haberkern-lab/ethoVR/README.md

# ethoVR Documentation
Documentation for a Unity-based virtual reality system for neurobiology and ethology applications.
