haberkern-lab/ethoVR/index.md

---
layout: default
title: Home
nav_order: 1
permalink: /
---

## ethoVR
{: .fs-9 }

Documentation for a Unity-based virtual reality system for neurobiology and ethology applications.
{: .fs-6 .fw-300 }

This documentation is meant as a practical guide for scientists to set up their own Unity-based virtual reality system using modules from the Janelia Unity Toolkit. In addition to "How-to guides" for the modular software, this website provides information to hardware, design files for custom 3D printed parts and assembly instructions.

If you use tools described on this website, please reference the following manuscript:
> [Maintaining a stable head direction representation in naturalistic visual environments](https://biorxiv.org/content/10.1101/2022.05.17.492284v1.full).
> Hannah Haberkern, Shivam S Chitnis, Philip M Hubbard, Tobias Goulet, Ann M Hermundstad, Vivek Jayaraman
> bioRxiv 2022.05.17.492284; doi: https://doi.org/10.1101/2022.05.17.492284

For the Janelia Unity Toolkit, please cite the following DOI:
> Philip Hubbard. (2022). 
> JaneliaSciComp/janelia-unity-toolkit: v1.1.0 (v1.1.0). 
> Zenodo. https://doi.org/10.5281/zenodo.7032144

The Janelia Unity Toolkit provides software packages that extend Unity functionality in a modular manner to accommodate specialized needs for applications of virtual reality to neuroscience and (neuro-)ethology. These packages allow precise control of frame rate, setup of a panoramic display, a connection with FicTrac via socket connection, custom collision handling, data logging and more. In addition, here we provide information on building hardware for a virtual reality system that permits neural recordings in behaving insects.

[Get started now](https://haberkern-lab.github.io/ethoVR/getting-started/){: .btn .btn-primary .fs-5 .mb-4 .mb-md-0 .mr-2 }  [Janelia Unity Toolkit](https://github.com/JaneliaSciComp/janelia-unity-toolkit){: .btn .fs-5 .mb-4 .mb-md-0 }

---

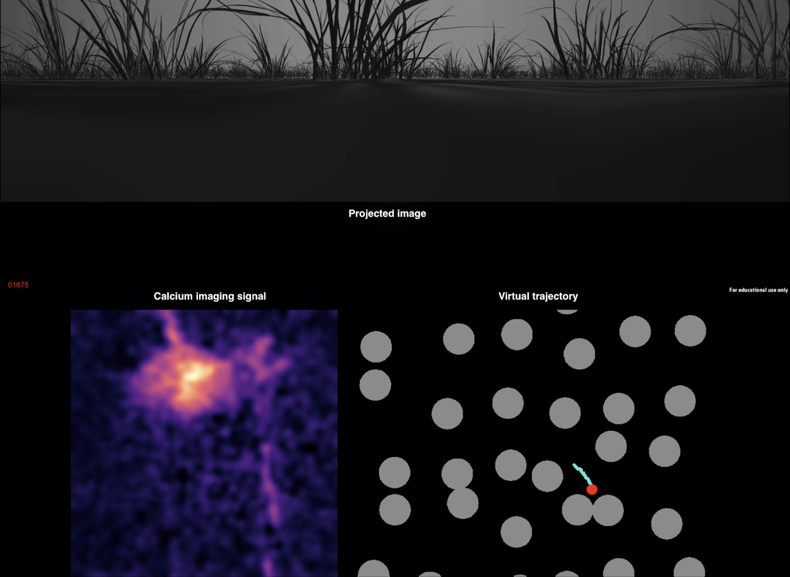
[picture p6: assets/DemoImage.png]
intro image

##### An example application where a fly explored an immersive visual virtual reality during simultaneous two-photon calcium imaging.
