haberkern-lab/ethoVR/assets/coolingForProjectors/image001.png

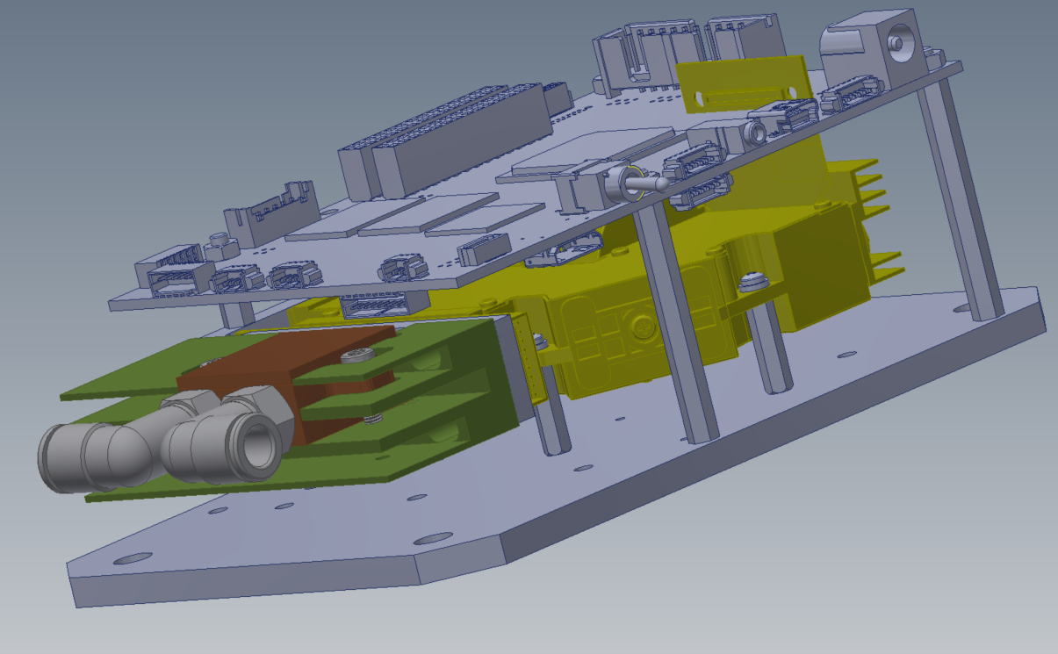
assets/coolingForProjectors/image001.png
