haberkern-lab/ethoVR/assets/coolingForProjectors/image002.png

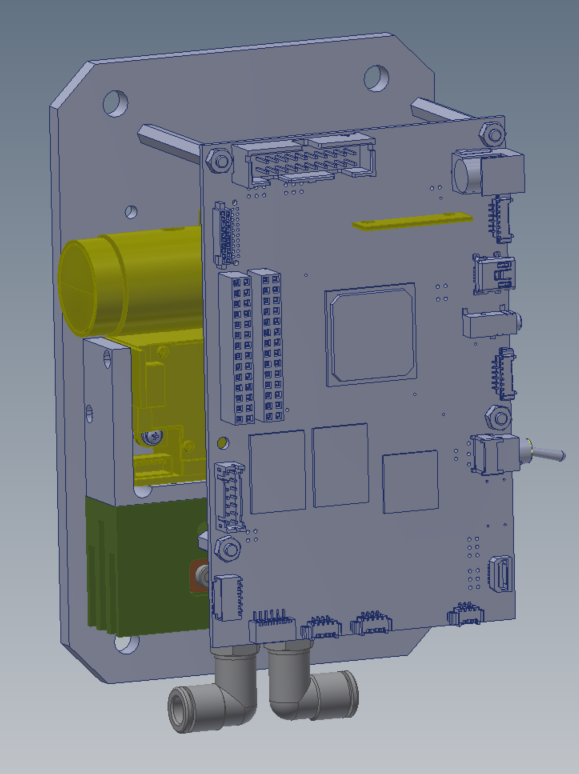
assets/coolingForProjectors/image002.png
