haberkern-lab/ethoVR/assets/coolingForProjectors/image003.png

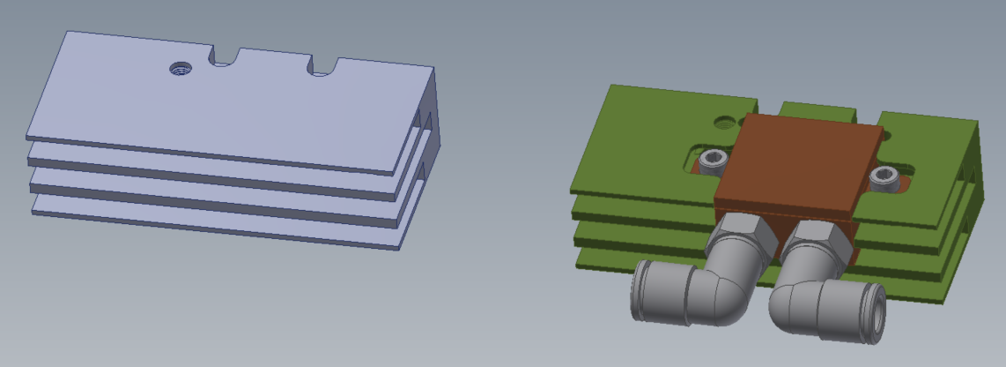
assets/coolingForProjectors/image003.png
