haberkern-lab/ethoVR/assets/coolingForProjectors/image004.png

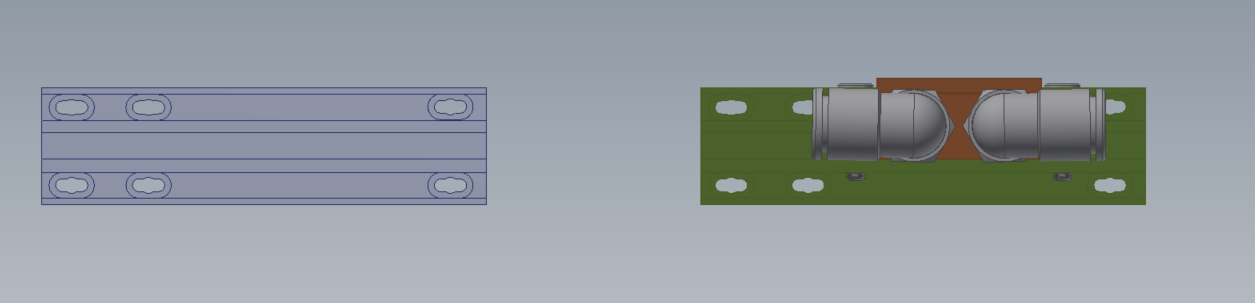
assets/coolingForProjectors/image004.png
