haberkern-lab/ethoVR/assets/display/3projectorScreen_rendering.png

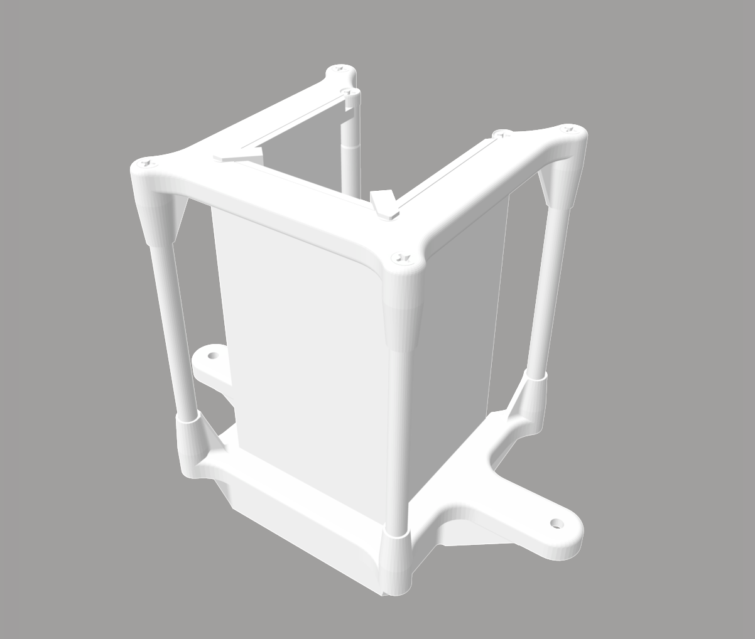
assets/display/3projectorScreen_rendering.png
