haberkern-lab/ethoVR/assets/display/4projectorScreen/displayLayout_front.png

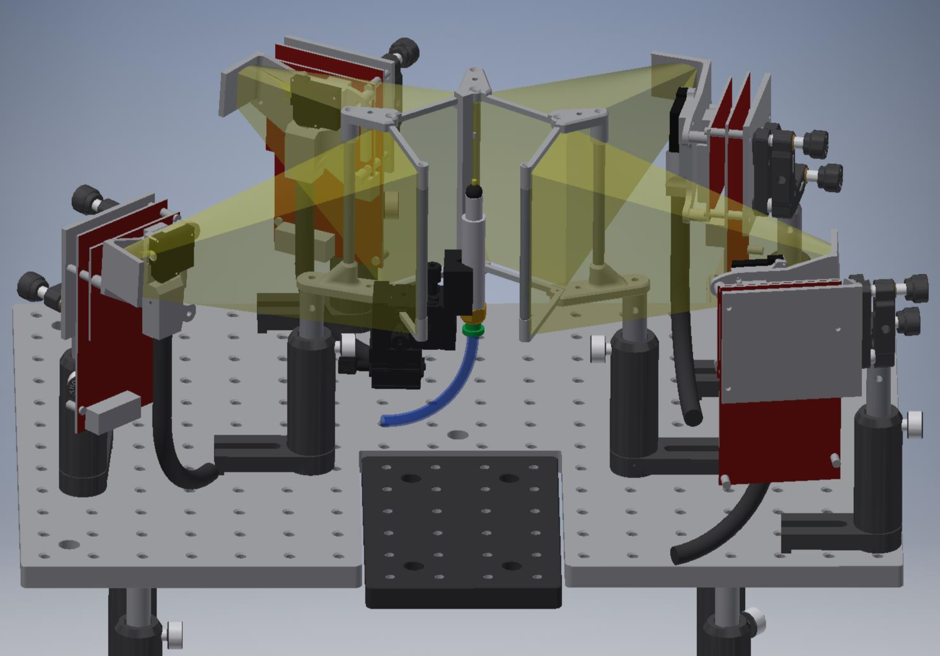
assets/display/4projectorScreen/displayLayout_front.png
