haberkern-lab/ethoVR/assets/display/4projectorScreen/displayLayout_side.png

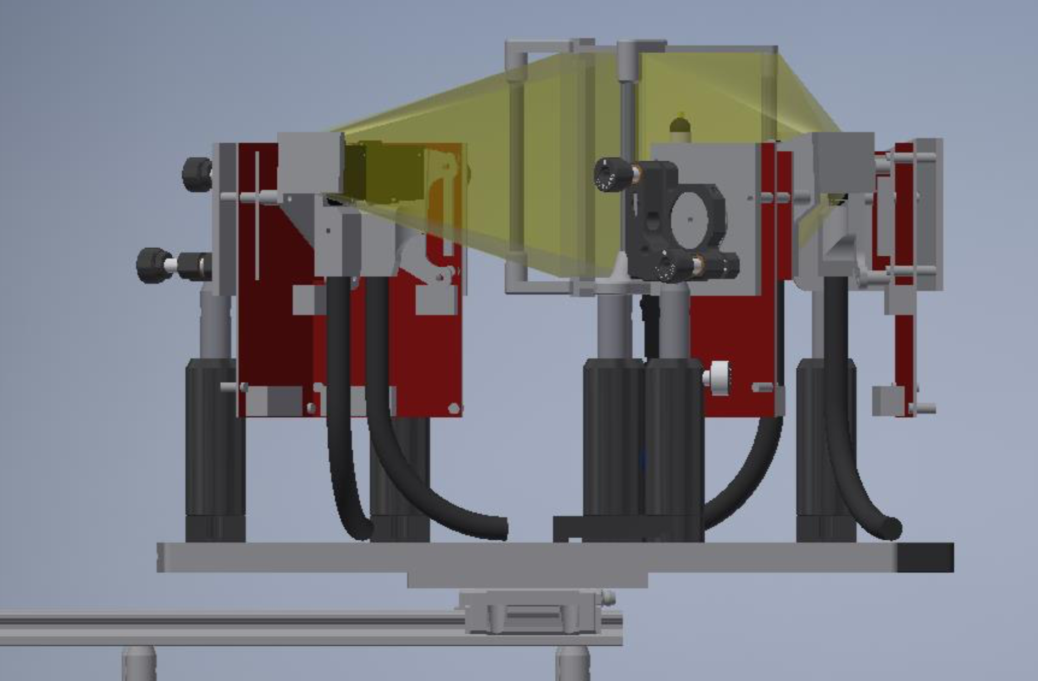
assets/display/4projectorScreen/displayLayout_side.png
