haberkern-lab/ethoVR/assets/display/4projectorScreen/displayLayout_top.png

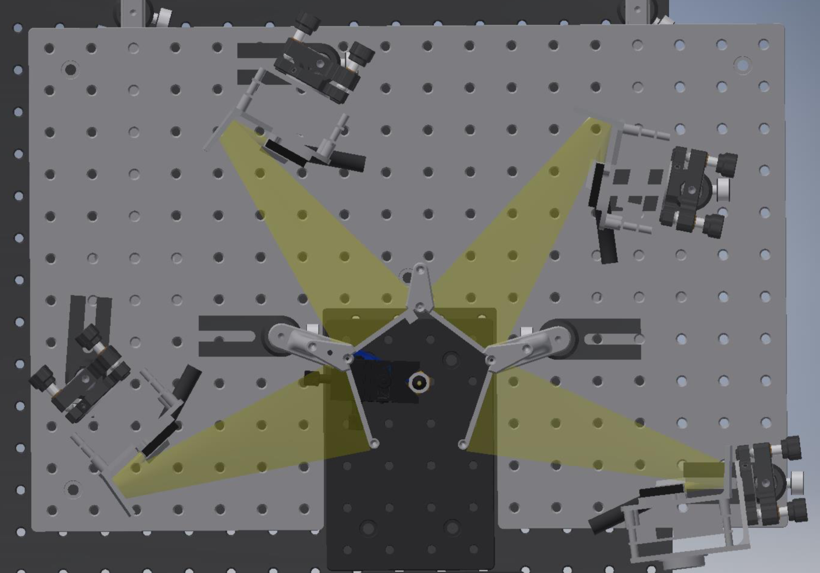
assets/display/4projectorScreen/displayLayout_top.png
