haberkern-lab/ethoVR/assets/display/imagingRig_projectors_photo.jpg

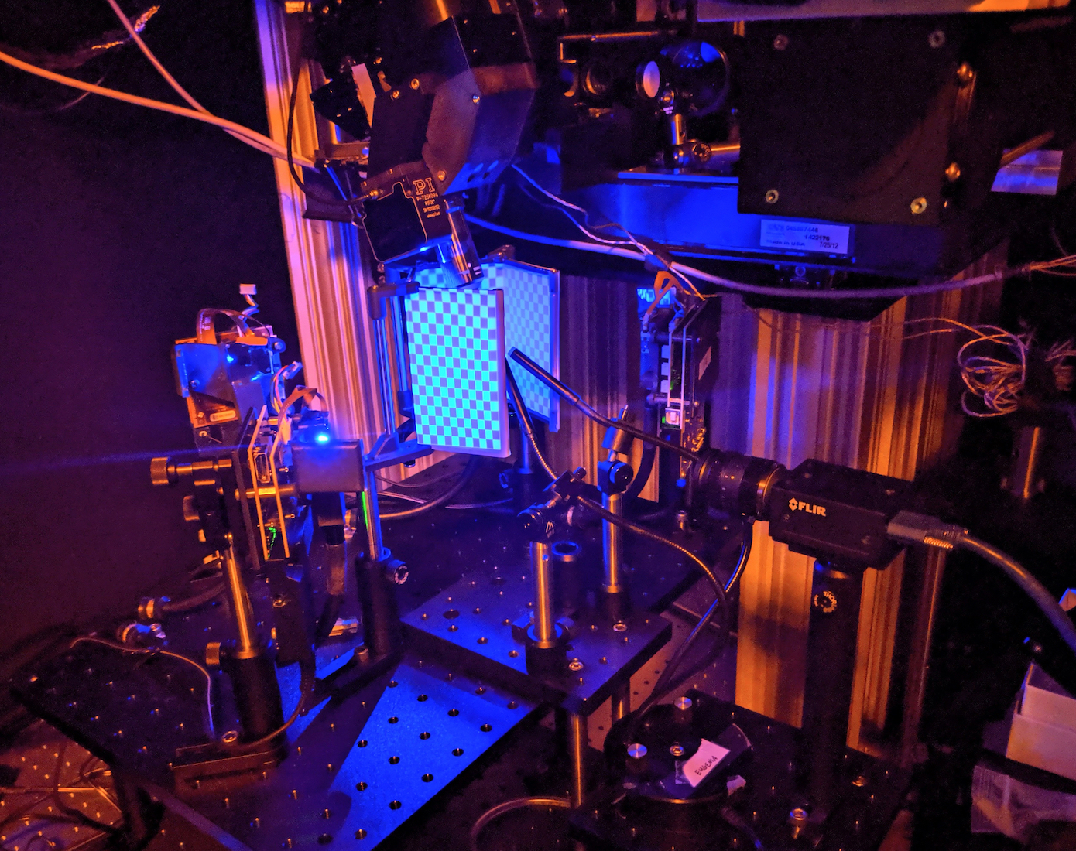
assets/display/imagingRig_projectors_photo.jpg
