haberkern-lab/ethoVR/assets/display/screen_styles.jpg

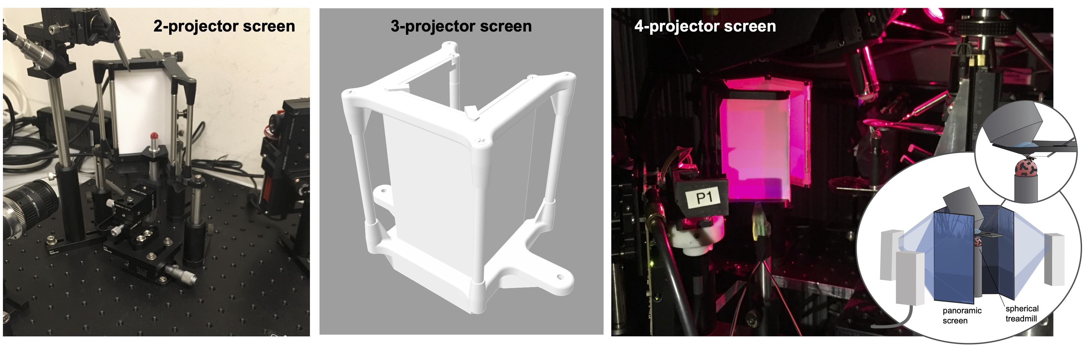
assets/display/screen_styles.jpg
