haberkern-lab/ethoVR/assets/fictrac/fictrac-configImg.png

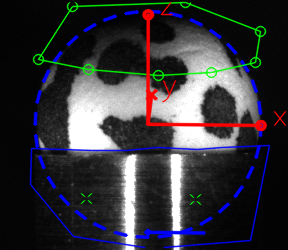
assets/fictrac/fictrac-configImg.png
