haberkern-lab/ethoVR/assets/flyholder/flyholder_connector.png

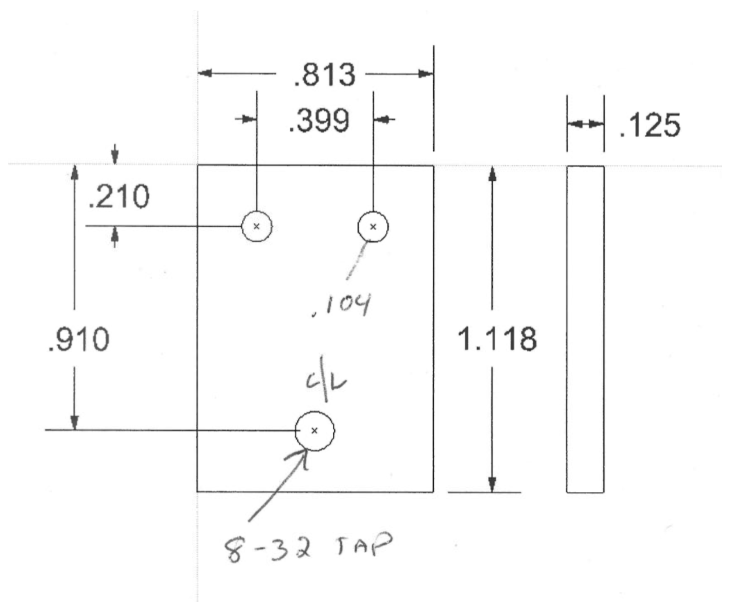
assets/flyholder/flyholder_connector.png
