haberkern-lab/ethoVR/assets/flyholder/frame2.png

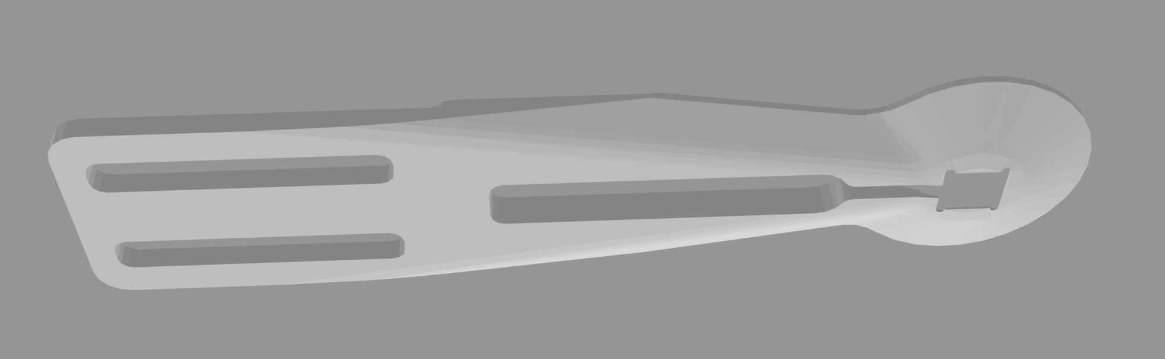
assets/flyholder/frame2.png
