haberkern-lab/ethoVR/assets/flyholder/frame.png

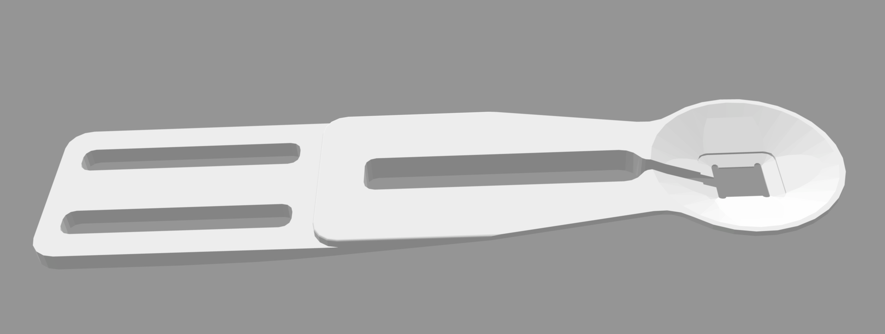
assets/flyholder/frame.png
