haberkern-lab/ethoVR/assets/screenDimensions.png

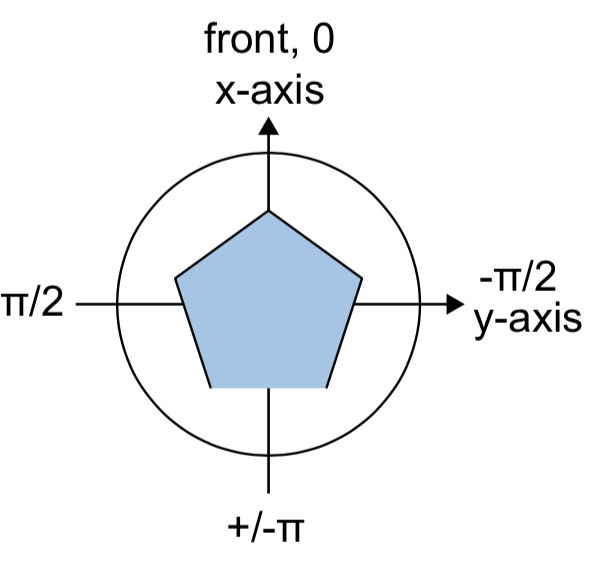
assets/screenDimensions.png
