haberkern-lab/ethoVR/assets/display/2projectorScreen/SCREEN ASSEMBLY GUIDE.stl

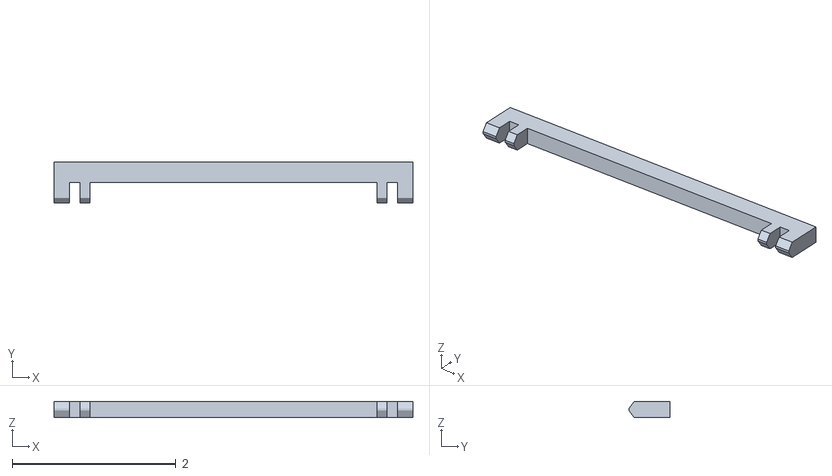
[picture p22: CAD file, 2022-11-30]
assets/display/2projectorScreen/SCREEN ASSEMBLY GUIDE.stl
4.39 x 0.5 x 0.2
