haberkern-lab/ethoVR/assets/modelfiles/fullAssembly 3P.stl

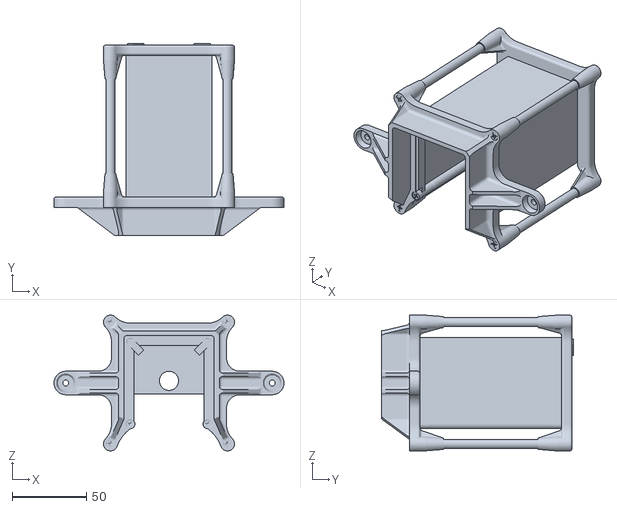
[picture p23: CAD file, 2026-02-27]
assets/modelfiles/fullAssembly 3P.stl
154.8 x 129.3 x 91.4
