haberkern-lab/ethoVR/assets/modelfiles/SCREEN ASSEMBLY GUIDE 3P.stl

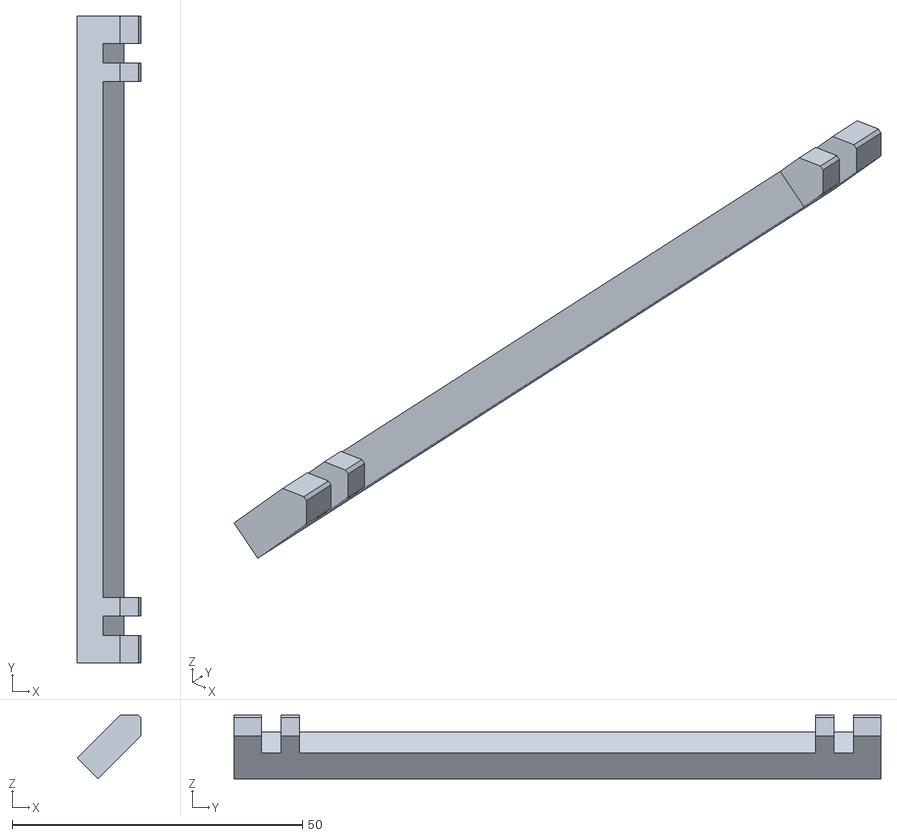
[picture p24: CAD file, 2024-01-26]
assets/modelfiles/SCREEN ASSEMBLY GUIDE 3P.stl
11.0 x 111.4 x 11.0
