haberkern-lab/ethoVR/assets/display/4projectorScreen/TOP SCREEN SUPPORT FRAME.stl

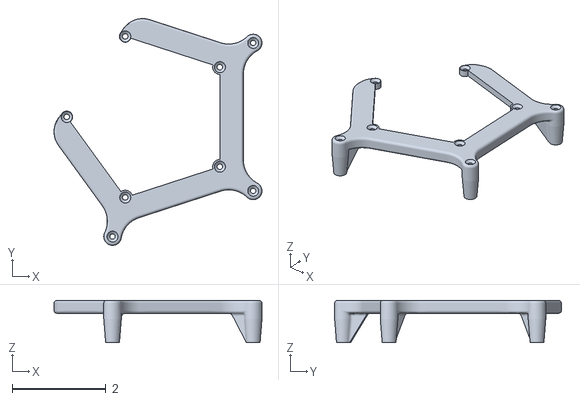
[picture p25: CAD file, 2022-11-30]
assets/display/4projectorScreen/TOP SCREEN SUPPORT FRAME.stl
4.43 x 4.83 x 0.9
