haberkern-lab/ethoVR/assets/display/projectorModification_lightguide/XY SLIDE PLATE.stl

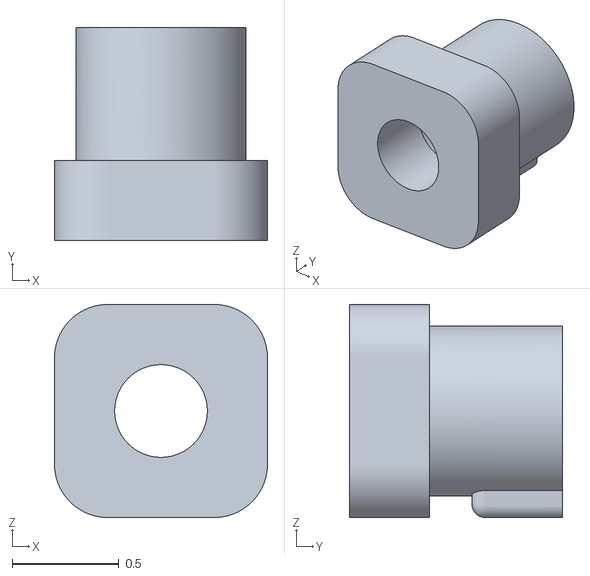
[picture p26: CAD file, 2022-12-06]
assets/display/projectorModification_lightguide/XY SLIDE PLATE.stl
1.00 x 1.00 x 1.00
