haberkern-lab/ethoVR/assets/display/projectorMount/3010 MOUNT PLATE.stp

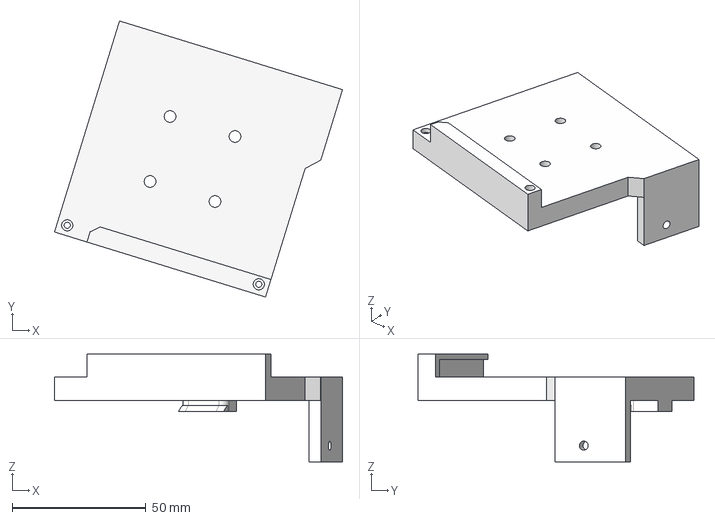
[picture p27: CAD file, 2024-01-26]
assets/display/projectorMount/3010 MOUNT PLATE.stp
107.7 x 103.2 x 40.3 mm
