haberkern-lab/ethoVR/assets/flyholder/FlyHolder_PyramidMount_V3_WIDEVIEW.stp

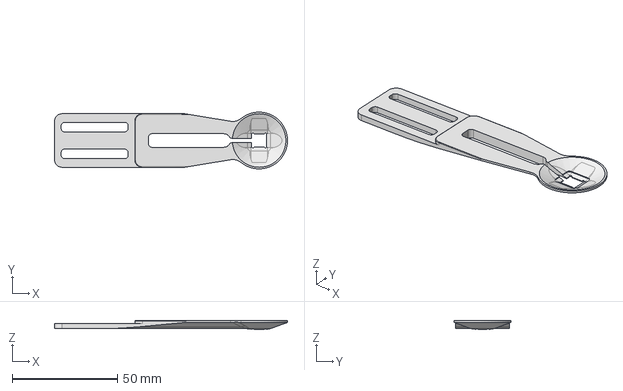
[picture p28: CAD file, 2022-12-21]
assets/flyholder/FlyHolder_PyramidMount_V3_WIDEVIEW.stp
110.5 x 27.0 x 4.09 mm
