haberkern-lab/ethoVR/assets/TreadmillHolder_V2.stl

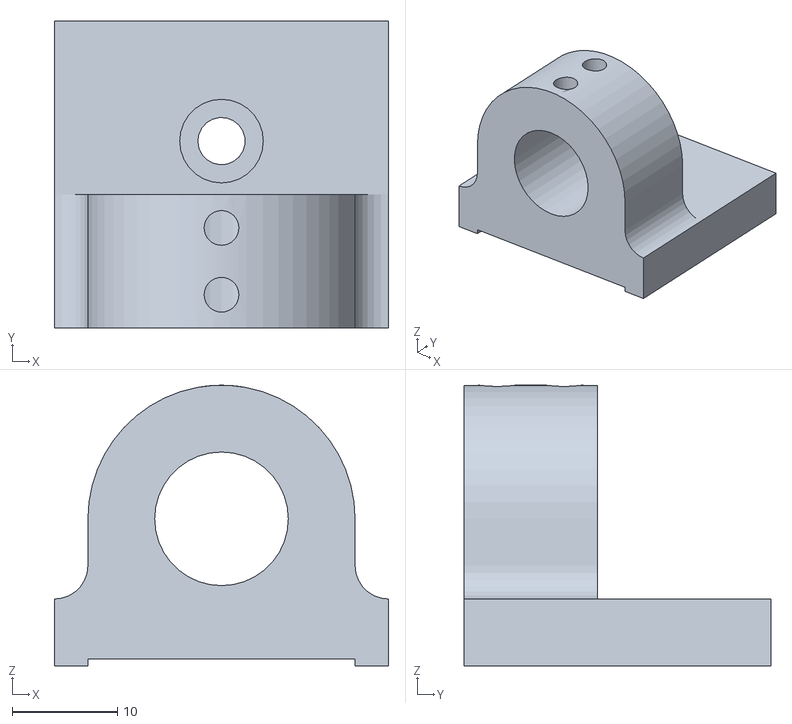
[picture p29: CAD file, 2024-01-26]
assets/TreadmillHolder_V2.stl
31.8 x 29.2 x 26.7
