haberkern-lab/ethoVR/assets/display/4projectorScreen/BOTTOM SCREEN SUPPORT FRAME.stl

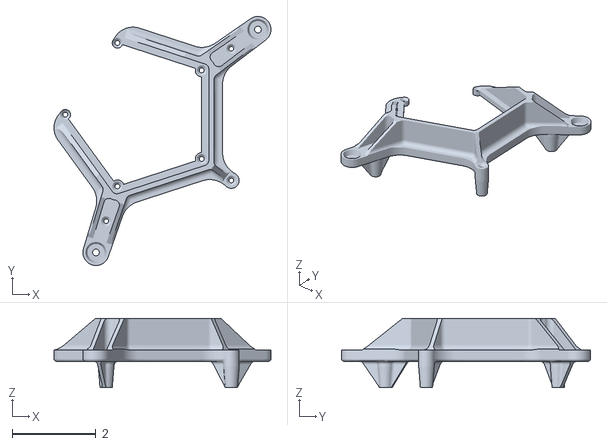
[picture p30: CAD file, 2022-11-30]
assets/display/4projectorScreen/BOTTOM SCREEN SUPPORT FRAME.stl
5.19 x 5.95 x 1.65
