haberkern-lab/ethoVR/assets/display/projectorModification_lightguide/PROJECTOR MOUNT FOR ADJ XY LLG V2.stl

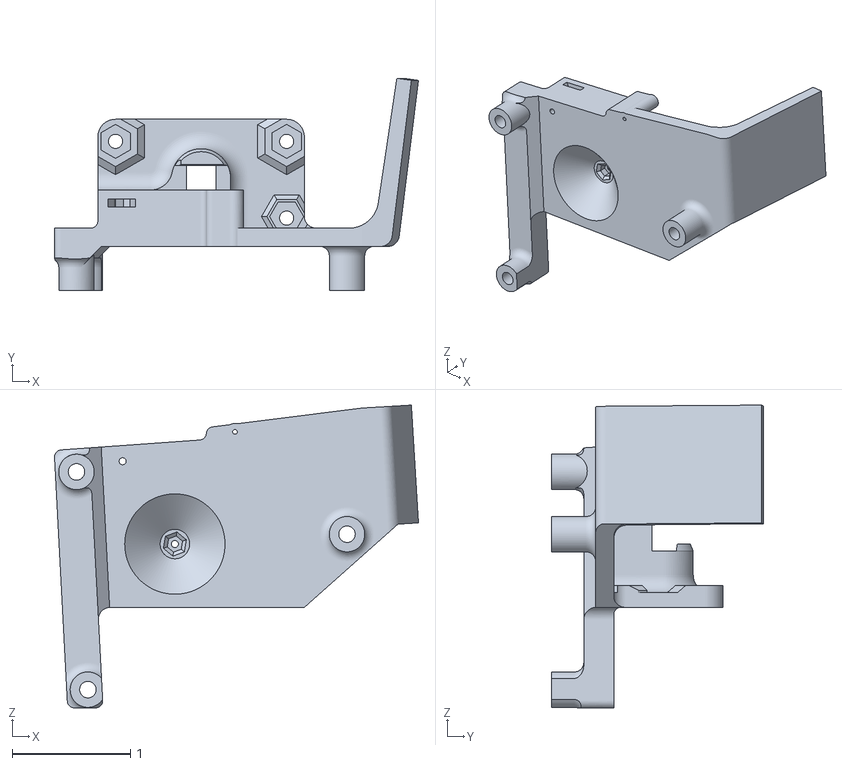
[picture p31: CAD file, 2022-12-06]
assets/display/projectorModification_lightguide/PROJECTOR MOUNT FOR ADJ XY LLG V2.stl
3.08 x 1.80 x 2.57
