haberkern-lab/ethoVR/assets/display/projectorMount/PCB BRACE.stp

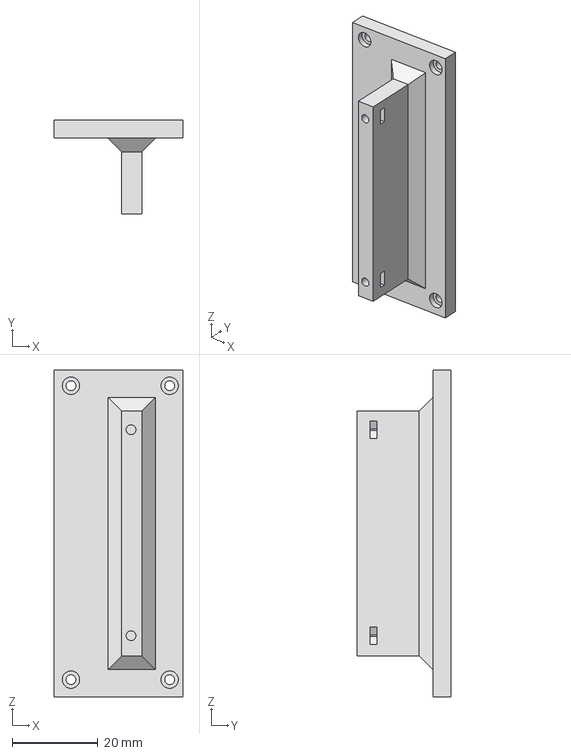
[picture p32: CAD file, 2024-01-26]
assets/display/projectorMount/PCB BRACE.stp
30.0 x 21.8 x 76.2 mm
