haberkern-lab/ethoVR/assets/flyholder/METAL_FLY_PYRAMID_CENTERED_V2.dxf

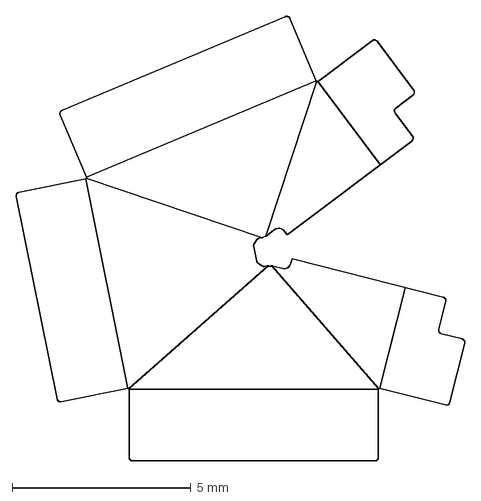
[picture p33: CAD file, 2022-12-21]
assets/flyholder/METAL_FLY_PYRAMID_CENTERED_V2.dxf
12.5 x 12.4 mm
