haberkern-lab/ethoVR/assets/modelfiles/3010 MOUNT PLATE RETAINER.stl

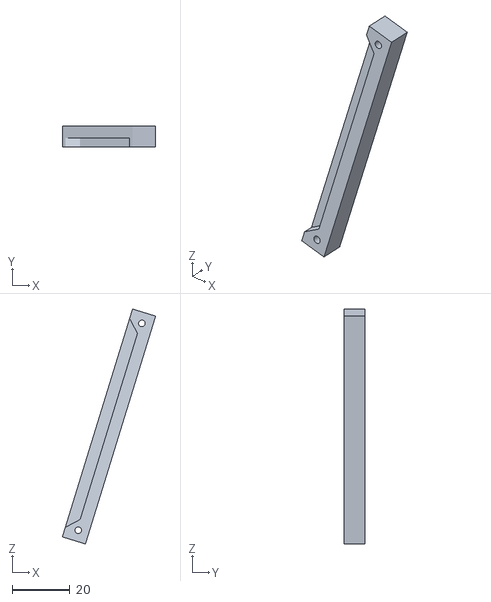
[picture p34: CAD file, 2024-01-26]
assets/modelfiles/3010 MOUNT PLATE RETAINER.stl
32.3 x 7.24 x 81.4
