haberkern-lab/ethoVR/assets/display/4projectorScreen/WIDE SCREEN HOLDER 2x.stl

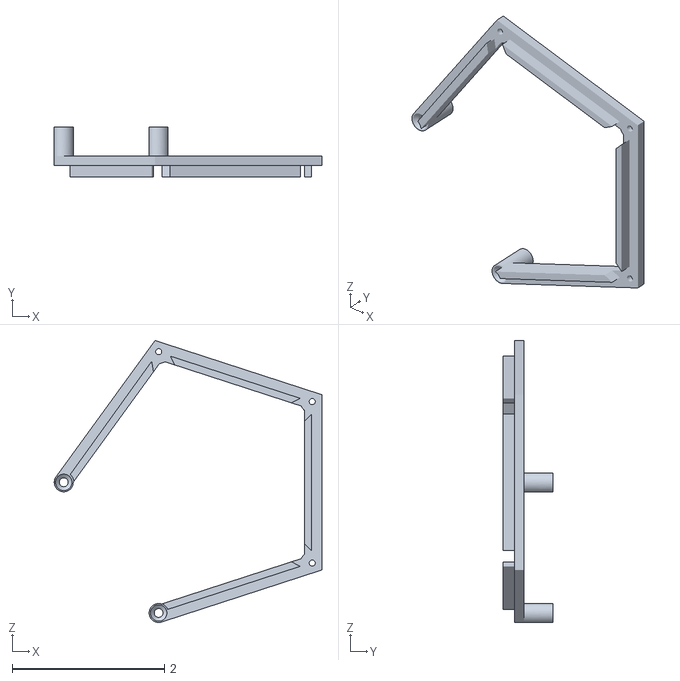
[picture p35: CAD file, 2022-11-30]
assets/display/4projectorScreen/WIDE SCREEN HOLDER 2x.stl
3.51 x 0.65 x 3.70
