haberkern-lab/ethoVR/assets/display/projectorModification_lightguide/XY SLIDE TOP.stl

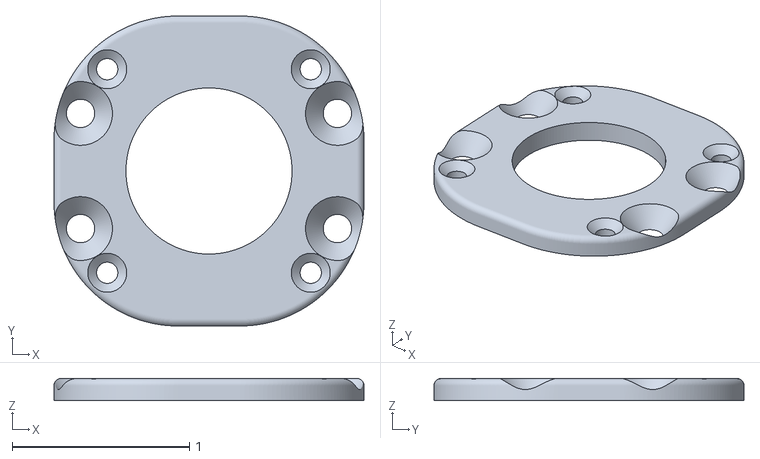
[picture p36: CAD file, 2022-12-06]
assets/display/projectorModification_lightguide/XY SLIDE TOP.stl
1.75 x 1.75 x 0.125
