haberkern-lab/ethoVR/assets/display/4projectorScreen/CENTERFINDING JIG.stl

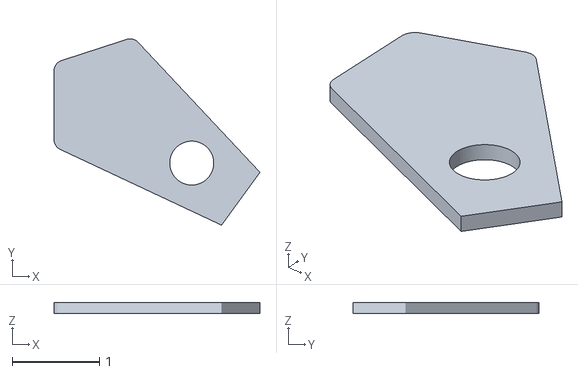
[picture p37: CAD file, 2022-11-30]
assets/display/4projectorScreen/CENTERFINDING JIG.stl
2.37 x 2.14 x 0.125
