haberkern-lab/ethoVR/assets/display/projectorModification_lightguide/XY SLIDE BOTTOM.stl

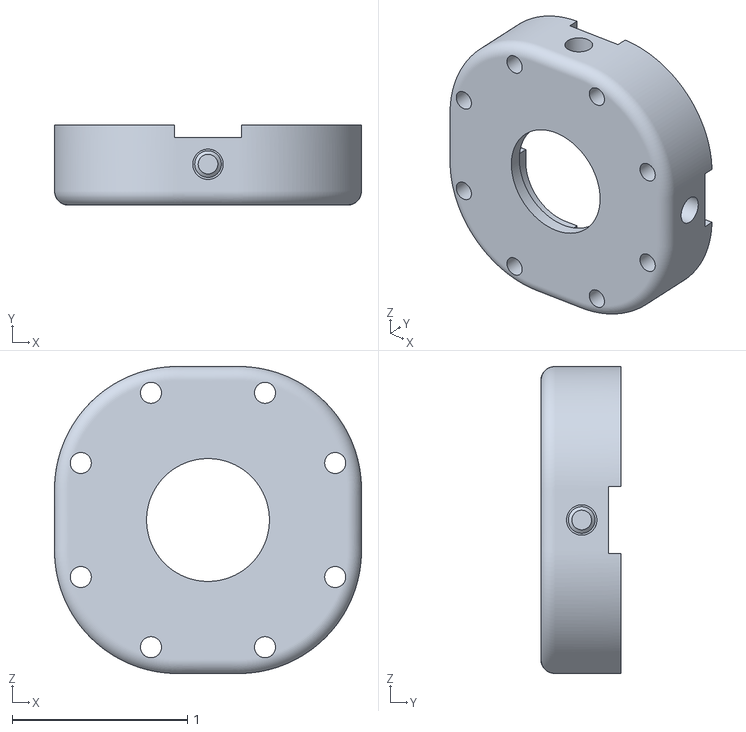
[picture p38: CAD file, 2022-12-06]
assets/display/projectorModification_lightguide/XY SLIDE BOTTOM.stl
1.75 x 0.458 x 1.75
