haberkern-lab/ethoVR/assets/display/projectorMount/CORNER FLYVR PIVOT MOUNTPLATE v2.stl

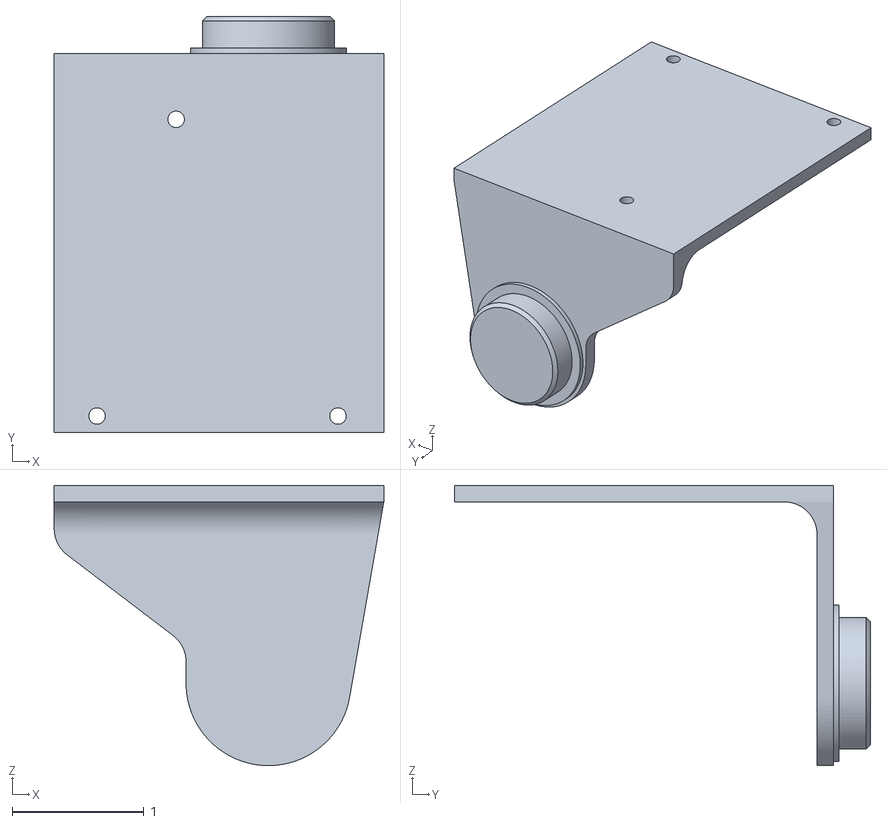
[picture p39: CAD file, 2022-12-06]
assets/display/projectorMount/CORNER FLYVR PIVOT MOUNTPLATE v2.stl
2.50 x 3.15 x 2.12
