haberkern-lab/ethoVR/assets/modelfiles/WIDE SCREEN HOLDER 3P.stl

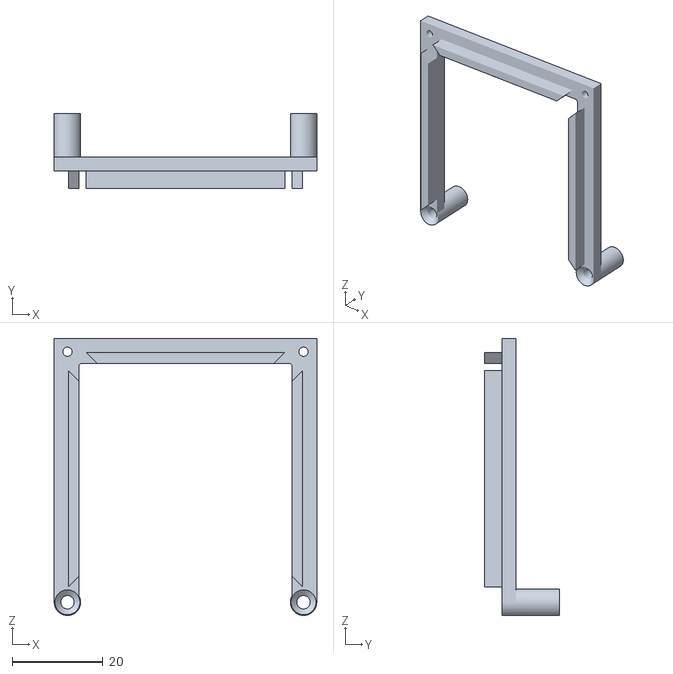
[picture p40: CAD file, 2024-01-26]
assets/modelfiles/WIDE SCREEN HOLDER 3P.stl
57.9 x 16.5 x 61.1
