haberkern-lab/ethoVR/assets/display/projectorModification_lightguide/PROJECTOR LIGHTBLOCK 2.stl

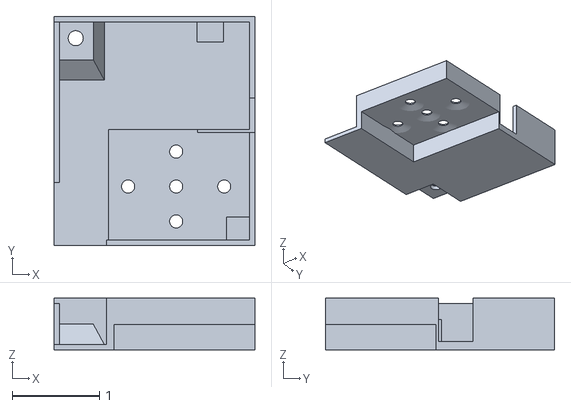
[picture p41: CAD file, 2022-12-06]
assets/display/projectorModification_lightguide/PROJECTOR LIGHTBLOCK 2.stl
2.30 x 2.62 x 0.595
