haberkern-lab/ethoVR/assets/display/projectorMount/FLYVR PIVOT MOUNTPLATE.stl

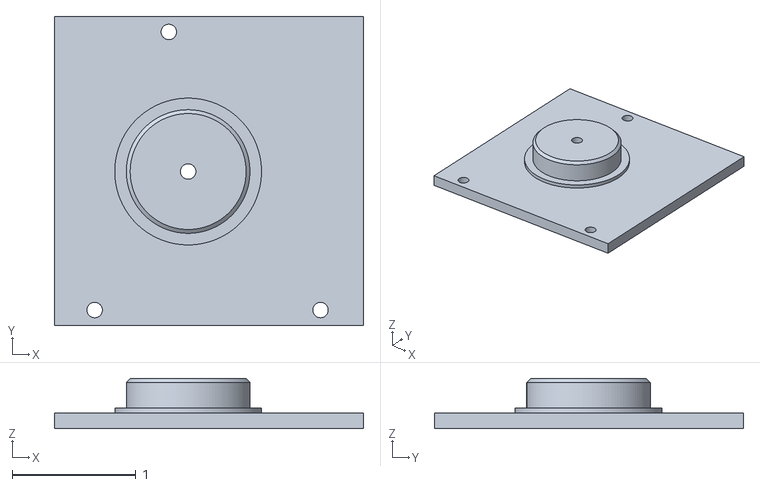
[picture p42: CAD file, 2022-12-06]
assets/display/projectorMount/FLYVR PIVOT MOUNTPLATE.stl
2.50 x 2.50 x 0.405
