haberkern-lab/ethoVR/assets/display/projectorModification_lightguide/LIGHT GUIDE ADAPTER.stl

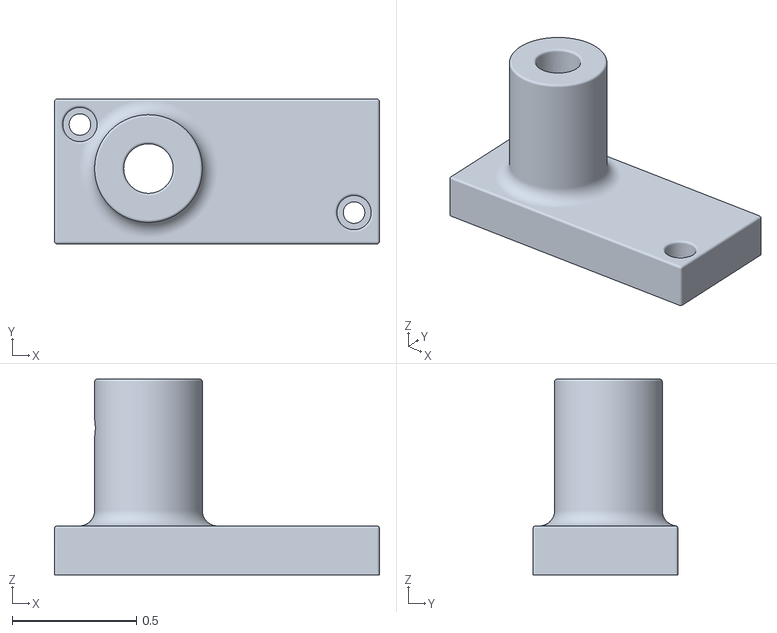
[picture p43: CAD file, 2022-11-30]
assets/display/projectorModification_lightguide/LIGHT GUIDE ADAPTER.stl
1.31 x 0.583 x 0.787
