haberkern-lab/ethoVR/assets/modelfiles/TOP SCREEN SUPPORT 3P FRAME.stl

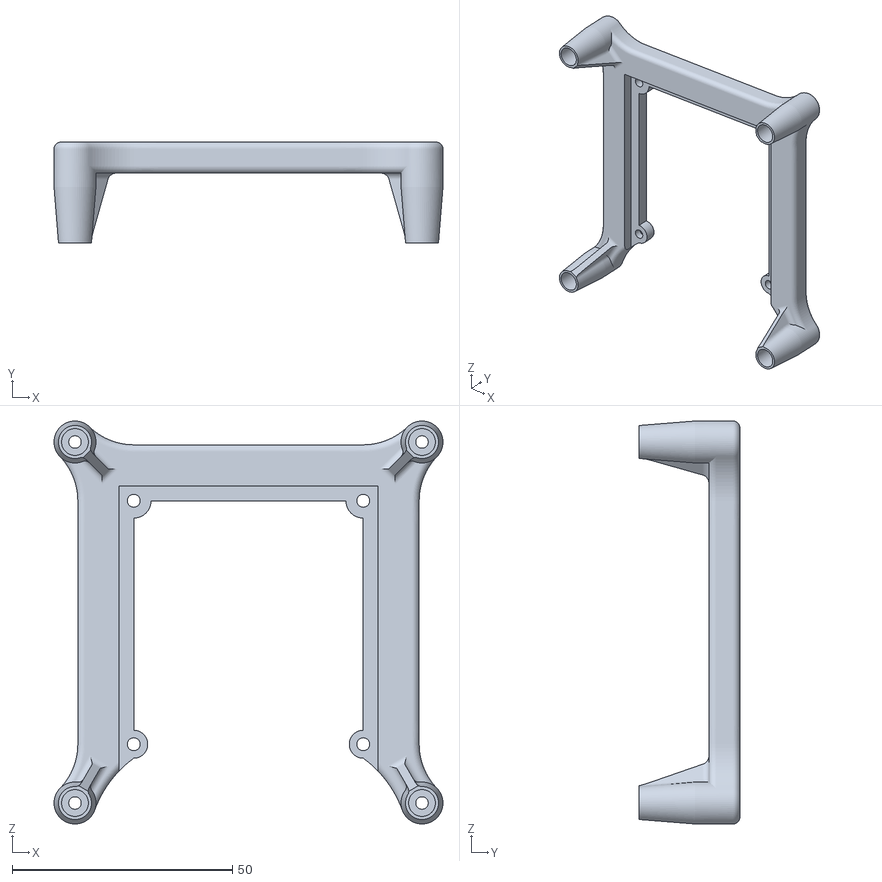
[picture p44: CAD file, 2024-01-26]
assets/modelfiles/TOP SCREEN SUPPORT 3P FRAME.stl
88.3 x 22.9 x 91.4
