haberkern-lab/ethoVR/assets/modelfiles/CENTERING JIG 3P.stl

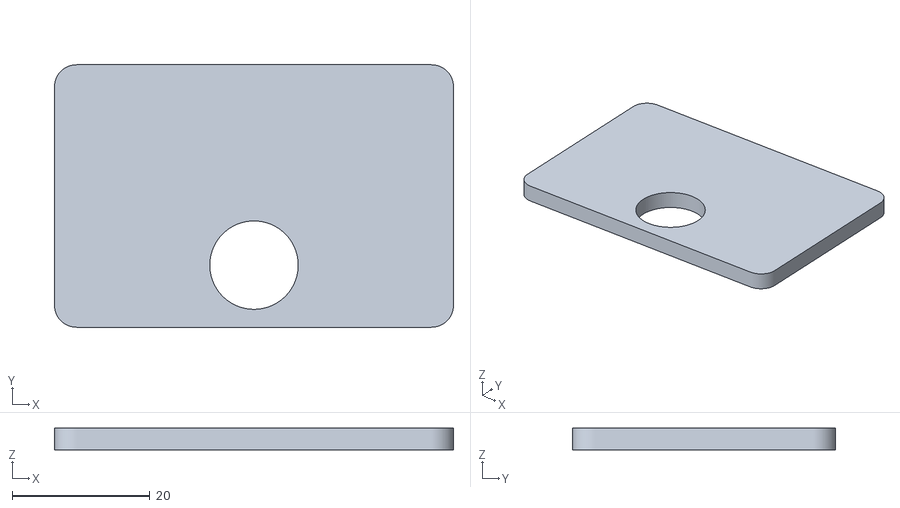
[picture p45: CAD file, 2024-01-26]
assets/modelfiles/CENTERING JIG 3P.stl
57.9 x 38.1 x 3.17
