haberkern-lab/ethoVR/assets/modelfiles/BOTTOM SCREEN SUPPORT 3P.stl

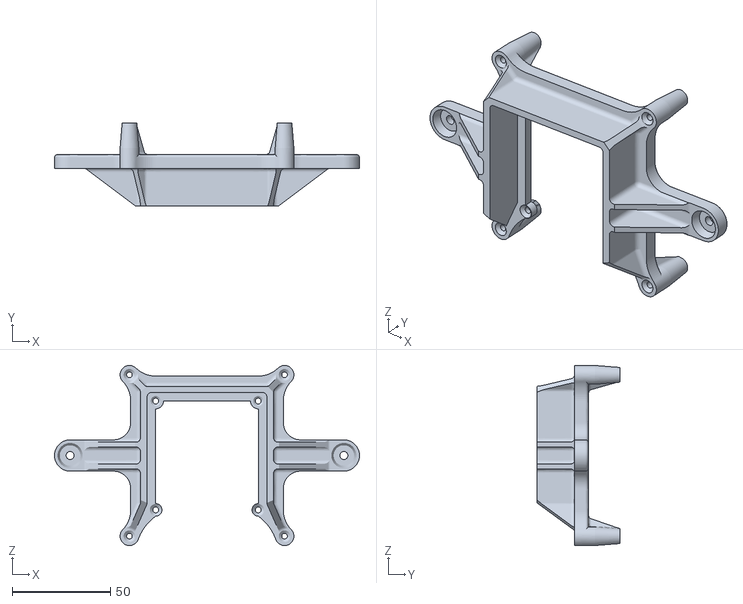
[picture p46: CAD file, 2024-01-26]
assets/modelfiles/BOTTOM SCREEN SUPPORT 3P.stl
154.8 x 41.9 x 91.4
