haberkern-lab/ethoVR/assets/modelfiles/ALIGNMENT JIG 2SCREEN.dxf

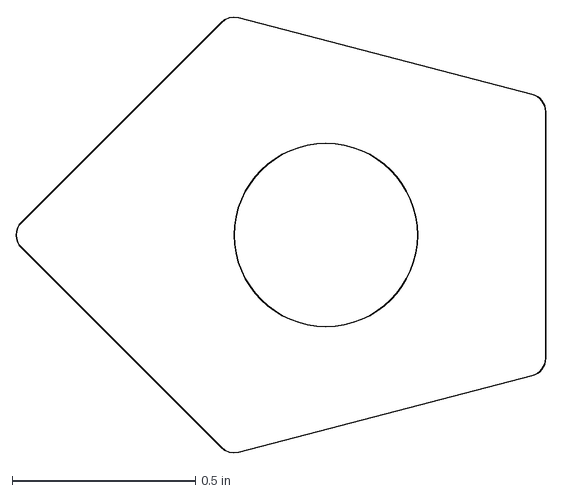
[picture p47: CAD file, 2024-01-26]
assets/modelfiles/ALIGNMENT JIG 2SCREEN.dxf
1.45 x 1.19 in
