haberkern-lab/ethoVR/assets/modelfiles/TOP SCREEN SUPPORT 2SCREEN FRAME.stp

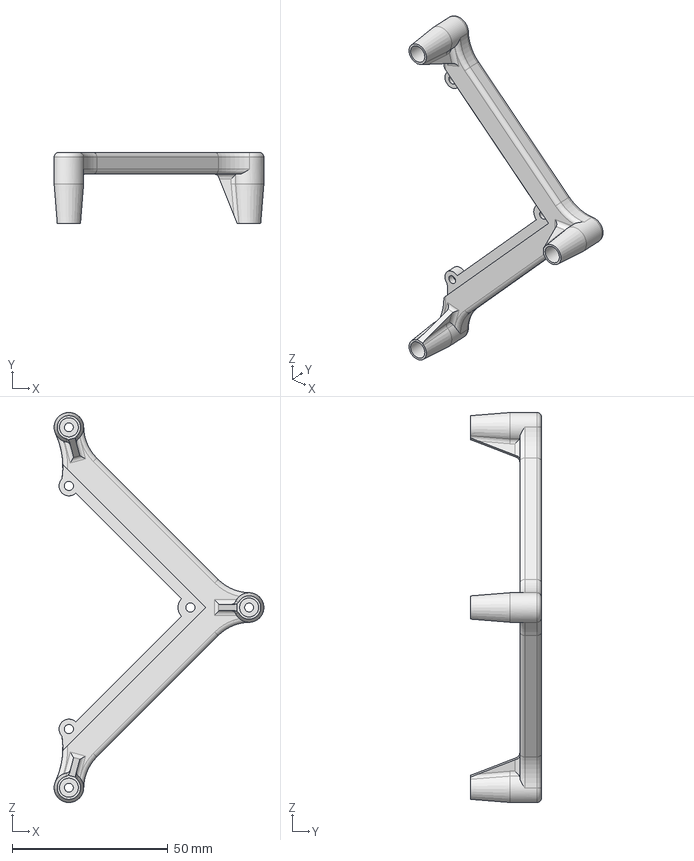
[picture p48: CAD file, 2024-01-26]
assets/modelfiles/TOP SCREEN SUPPORT 2SCREEN FRAME.stp
67.4 x 22.9 x 125.4 mm
