haberkern-lab/ethoVR/assets/modelfiles/BOTTOM SCREEN SUPPORT 2SCREEN.stp

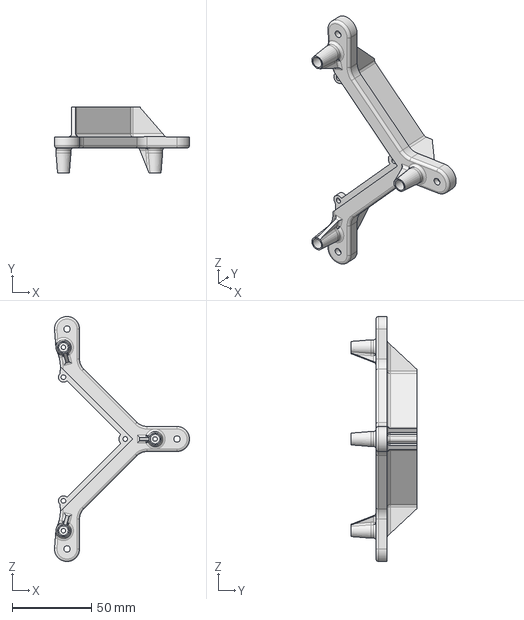
[picture p49: CAD file, 2024-01-26]
assets/modelfiles/BOTTOM SCREEN SUPPORT 2SCREEN.stp
85.4 x 41.9 x 154.9 mm
