haberkern-lab/ethoVR/assets/modelfiles/WIDE SCREEN HOLDER 2SCREEN.stp

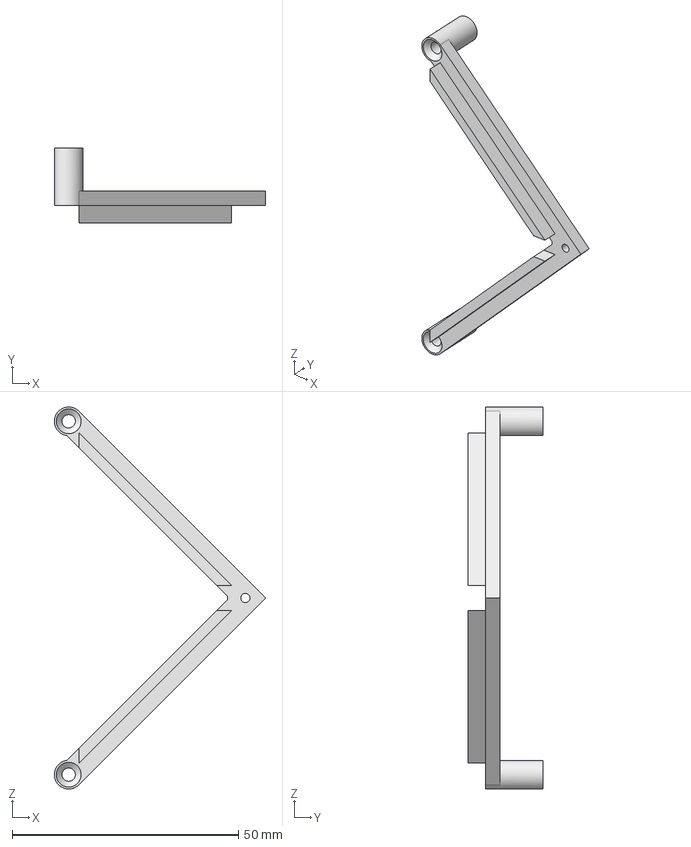
[picture p50: CAD file, 2024-01-26]
assets/modelfiles/WIDE SCREEN HOLDER 2SCREEN.stp
46.7 x 16.5 x 84.5 mm
