haberkern-lab/ethoVR/assets/modelfiles/XY LINEAR GUIDE BLOCKS.stl

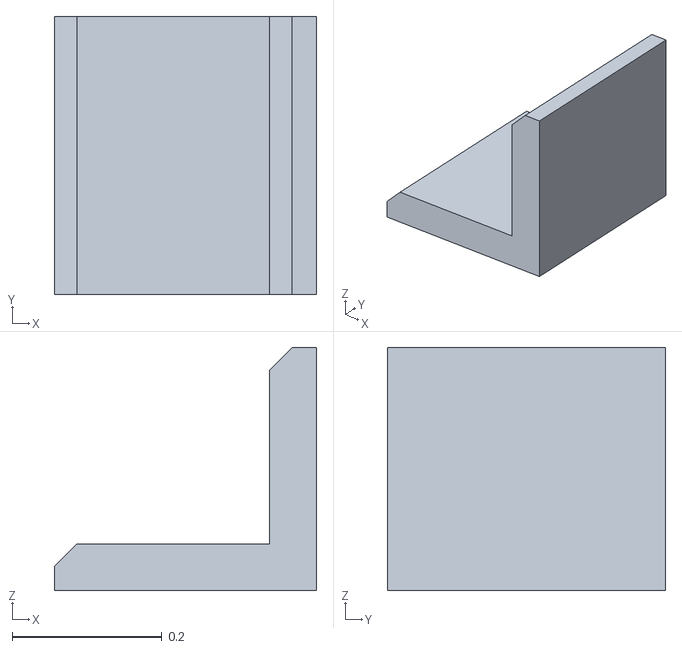
[picture p51: CAD file, 2022-12-06]
assets/modelfiles/XY LINEAR GUIDE BLOCKS.stl
0.35 x 0.372 x 0.325
