haberkern-lab/ethoVR/assets/modelfiles/PCB BRACE.stl

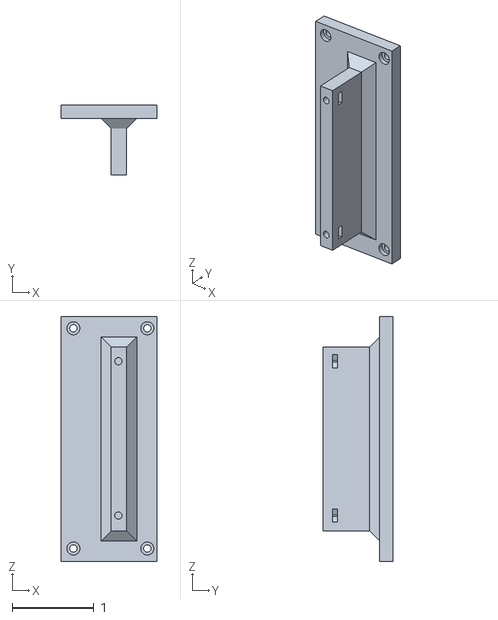
[picture p52: CAD file, 2022-11-30]
assets/modelfiles/PCB BRACE.stl
1.18 x 0.86 x 3.00
