haberkern-lab/ethoVR/(list of files, cad)

Other CAD files:
assets/modelfiles/SCREEN ASSEMBLY GUIDE 3P_MIR.stl
assets/display/projectorMount/3010 MOUNT PLATE RETAINER.stp
assets/modelfiles/3010 MOUNT PLATE.stl
assets/modelfiles/WIDE SCREEN HOLDER 3P_MIR.stl
assets/display/2projectorScreen/IPT (Native Inventor) Files/ALIGNMENT JIG 2SCREEN.ipt
assets/display/2projectorScreen/IPT (Native Inventor) Files/BOTTOM SCREEN SUPPORT 2SCREEN.ipt
assets/display/2projectorScreen/IPT (Native Inventor) Files/TOP SCREEN SUPPORT 2SCREEN FRAME.ipt
assets/display/2projectorScreen/IPT (Native Inventor) Files/WIDE SCREEN HOLDER 2SCREEN.ipt
assets/display/projectorMount/3010 MOUNT PLATE RETAINER.ipt
assets/display/projectorMount/3010 MOUNT PLATE.ipt
assets/display/projectorMount/3010 MOUNT PLATE.stl
assets/display/projectorMount/PCB BRACE.ipt
assets/flyholder/FlyHolder_PyramidMount_V3_WIDEVIEW.ipt
assets/flyholder/FlyHolder_PyramidMount_V3_WIDEVIEW.stl
assets/flyholder/METAL FLY PYRAMID CENTERED V2.ipt
assets/modelfiles/BOTTOM SCREEN SUPPORT 2SCREEN.stl
assets/modelfiles/TOP SCREEN SUPPORT 2SCREEN FRAME.stl
assets/modelfiles/WIDE SCREEN HOLDER 2SCREEN.stl
