haberkern-lab/ethoVR/assets/otherdocs/DLPDLCR2010EVM MODIFICATION GUIDE.pdf

# DLPDLCR2010EVM MODIFICATION GUIDE

## Disassembly

Before beginning make sure all power is disconnected and you are properly grounded to prevent damaging components. It is advisable to retain all screws, components, and hardware as some will be reused in the new configuration.

1. Remove the 2 screws holding the optical engine mounting plate. Gently invert the plate.

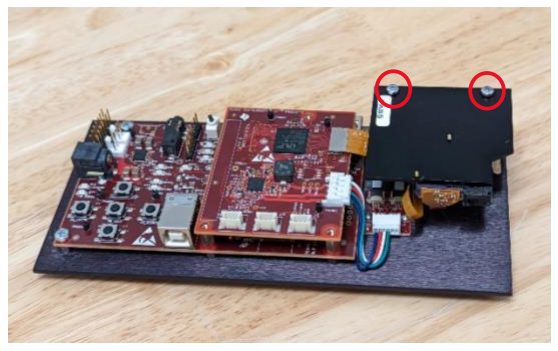
[picture p58: figure]

2. Disconnect the two LED ribbon cables either from the optical engine or the small circuit board.

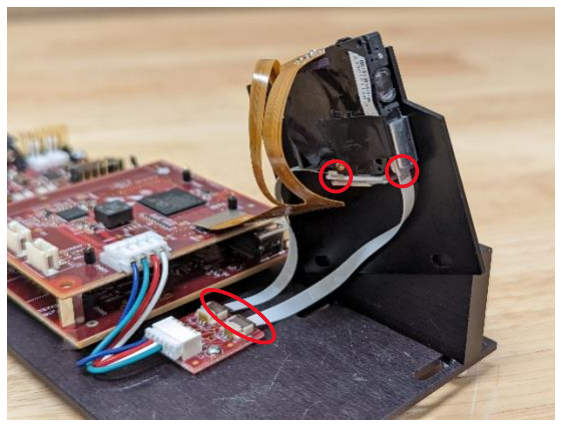
[picture p59: figure]

3. Gently pry the gold ribbon cable from the main circuit board.

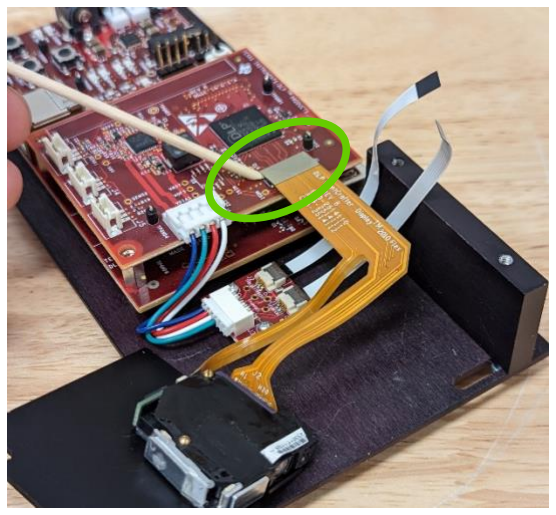
[picture p60: figure]

4. Remove the screws/nuts holding the optical engine to the plate and save them for a later step.
5. Pry off the LED assembly from the opposite side of the ribbon cable. The front LED assembly can be left in place.

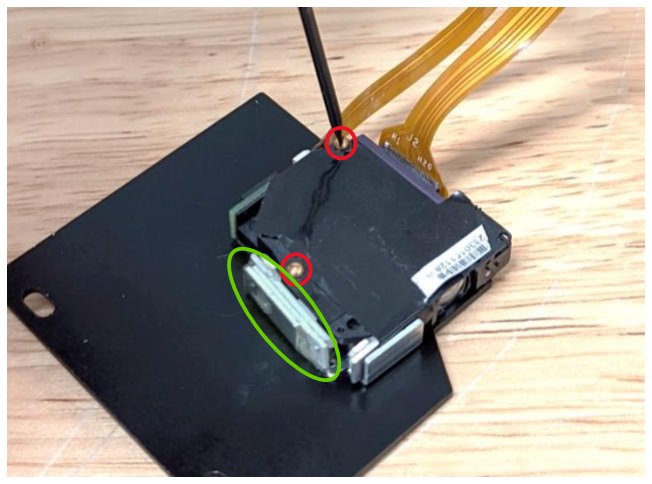
[picture p61: figure]

6. Remove the projector circuit board assembly from the base plate. Retain the 5 M3 screws for a later step.

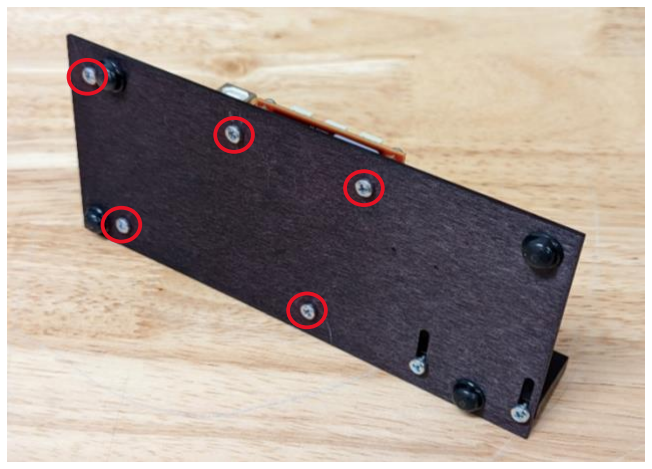
[picture p62: figure]

7. Disassembly complete. For modification you will need the optical engine, circuit board and fasteners mentioned above.

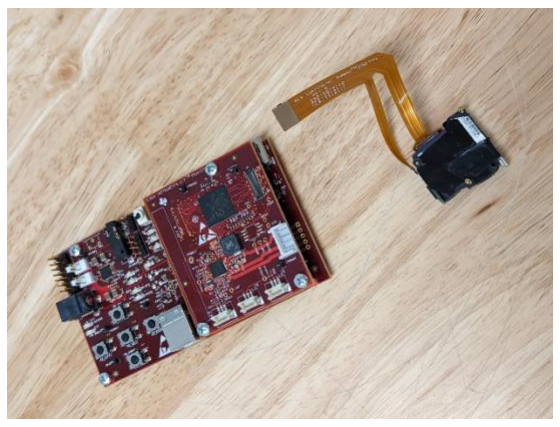
[picture p63: figure]

## Reassembly and modifications

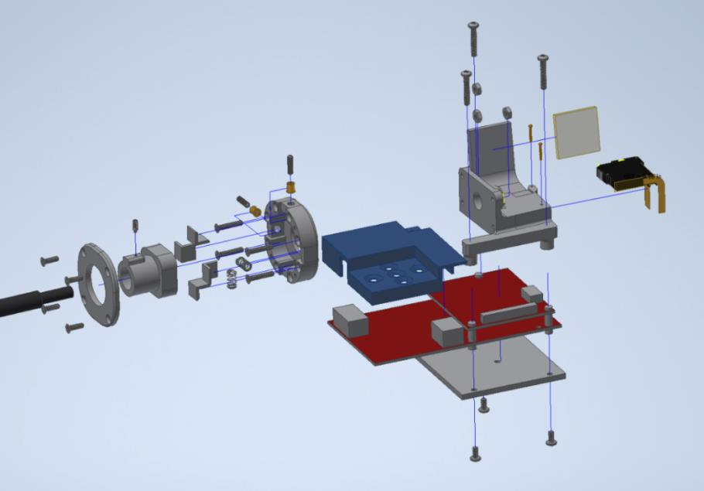
[picture p64: figure]

Projector modifications

Parts list:

- 1x Silver first surface mirror https://www.edmundoptics.com/p/25-x-25mm-silver-4-6lambdamirror/31987/ (https://www.edmundoptics.com/p/25-x-25mm-silver-4-6lambda-mirror/31987/)
- 3x 18mm M3 pan head screws https://www.mcmaster.com/92000A127/
- 3x 6mm M3 pan head screws https://www.mcmaster.com/90116A151/
- 3x #4-40 nuts https://www.mcmaster.com/91841A005/
- 2x #00-96 screws https://www.mcmaster.com/92453A862/
- VHB tape https://www.mcmaster.com/75935A12/

3d printed parts:

- 1x PROJECTOR MOUNT FOR ADJ XY LLG
- 1x PROJECTOR LIGHTBLOCK (Optional, simpler methods for blocking board LEDs exist)
- 1x FLYVR PIVOT MOUNTPLATE
- 1x CORNER FLYVR PIVOT MOUNTPLATE (Optional, helpful if space is limited)

Modification

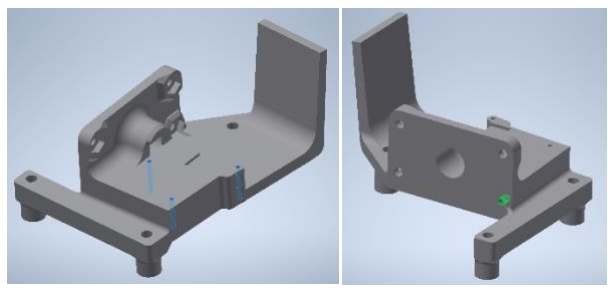
[picture p65: figure]

1. Prepare the PROJECTOR MOUNT FOR ADJ
XY LLG for assembly by using the #00-96 screws to cut threads into the printed holes and tap the hole on the vertical face for a #4-40 screw.

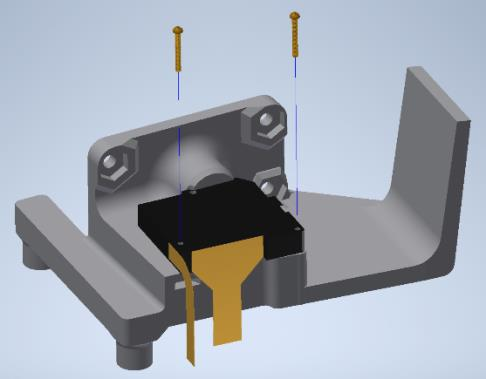
[picture p66: figure]

2. Place the optical engine and ribbon cables onto the PROJECTOR MOUNT FOR ADJ XY LLG and secure with the screw from disassembly step #4.

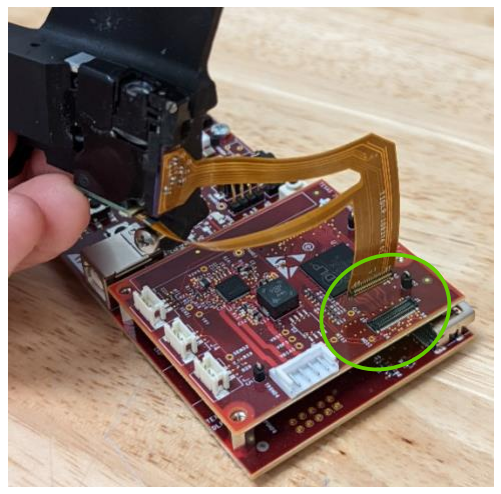
[picture p67: figure]

3. Carefully connect the ribbon cable from the optical engine to the circuit board.
4. Gently fold the assembly over the circuit board and secure with 3 18mm M3 pan heads.

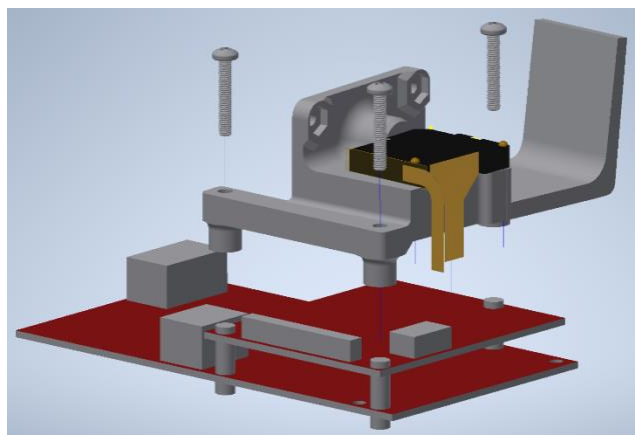
[picture p68: figure]
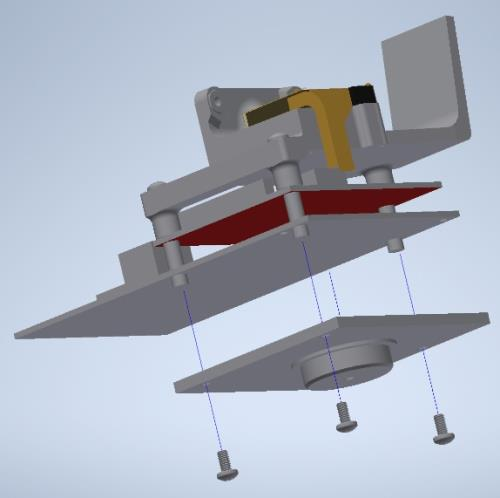
[picture p69: figure]

5. Place the FLYVR PIVOT MOUNTPLATE, secure with the M3 screws from disassembly step #6

### Liquid Light Guide Alignment Sub-Assembly

Allows for fine adjustment of the XY position of your light source relative to the optical engine.

Parts List: (Quantities are listed per projector assembly)

- 4x 4-40 flat head screws 0.375in https://www.mcmaster.com/91771A108/
- 4x 4-40 flat head screws 0.625in https://www.mcmaster.com/91771A112/
- 2x compression springs part # 70500 https://www.mwcomponents.com/shop/sp-co-a-13016?variant=1511977 (https://www.mwcomponents.com/shop/sp-co-a-13016?variant=1511977)

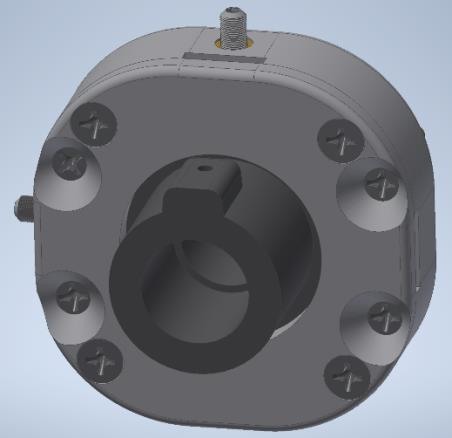
[picture p70: figure]

- 2x ultra fine threaded brass inserts https://www.mcmaster.com/98625A879/
- 2x ultra fine threaded M3 set screws https://www.mcmaster.com/98625A553/
- 1x 4-40 nylon tipped set screw https://www.mcmaster.com/90291A106/
- 1x Thorlabs KM100 mount https://www.thorlabs.com/thorproduct.cfm?partnumber=KM100
- 1x Thorlabs post https://www.thorlabs.com/thorproduct.cfm?partnumber=TR3
- 1x Thorlabs post holder https://www.thorlabs.com/thorproduct.cfm?partnumber=UPH3

3d Printed Parts: These should be printed on a resin or polyjet printer for accuracy.

- 1x XY SLIDE BOTTOM
- 1x XY SLIDE TOP
- 1x XY SLIDE PLATE
- 4x XY LINEAR GUIDE BLOCKS

### LLGA Fabrication

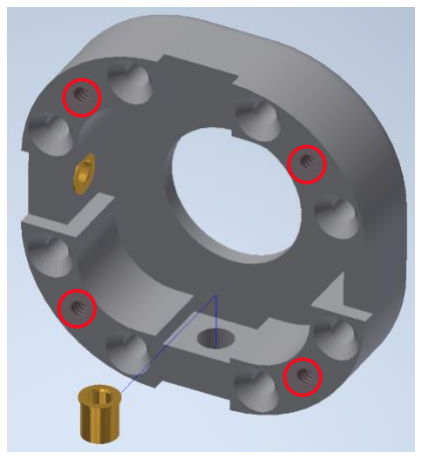
[picture p71: figure]

1. Press the ultra-fine threaded brass inserts into the XY SLIDE BOTTOM until their flanges are against the inner wall.

At this point the circled holes should be tapped for #4-40 screws.

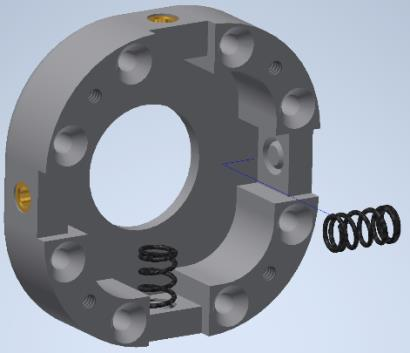
[picture p72: figure]

2. Install the compression springs in the recesses opposite the inserts. A small dab of epoxy or superglue can be used to secure the base of the spring in the recess.

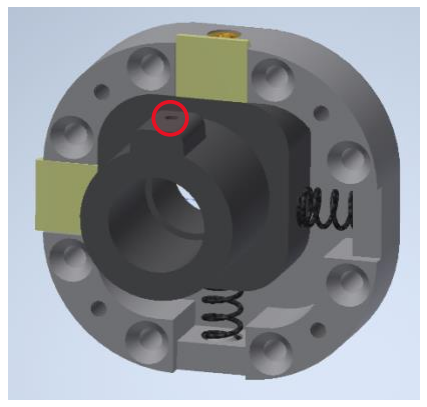
[picture p73: figure]

3. Tap the hole in the XY SLIDE PLATE for a #4-40 set screw.

Apply a small amount of oil to the base and sides of the XY SLIDE PLATE.

Place into the base along with 2 LINEAR GUIDE BLOCKS adjacent to the brass inserts.

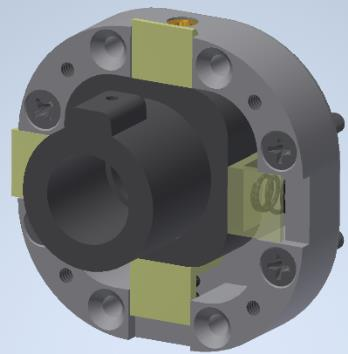
[picture p74: figure]

4. With tweezers compress the springs and slip the remaining LINEAR GUIDE BLOCKS into place.
5. Insert 4x 0.625in #4-40 screws into the countersunk holes. The orientation of the assembly can be changed per projector to allow for easier access to the ultrafine set screws.

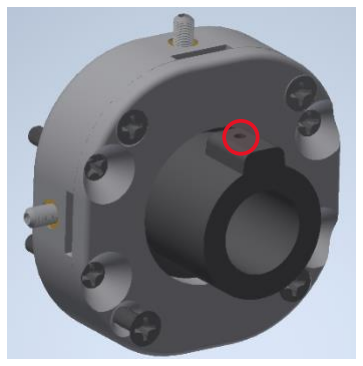
[picture p75: figure]

6. Place the XY SLIDE TOP onto the assembly and secure with 4x 0.375in #4-40 screws.
7. Insert ultrafine set screws into brass inserts. Adjust until the XY SLIDE PLATE is roughly centered.
8. Install the nylon tipped #4-40 set screw in the XY SLIDE PLATE.

### Joining the Sub-Assemblies

1. Insert 3 #4-40 nuts into the vertical plate on the PROJECTOR MOUNT FOR ADJ XY LLG and secure the LLGA sub assembly via the #4-40 screws.

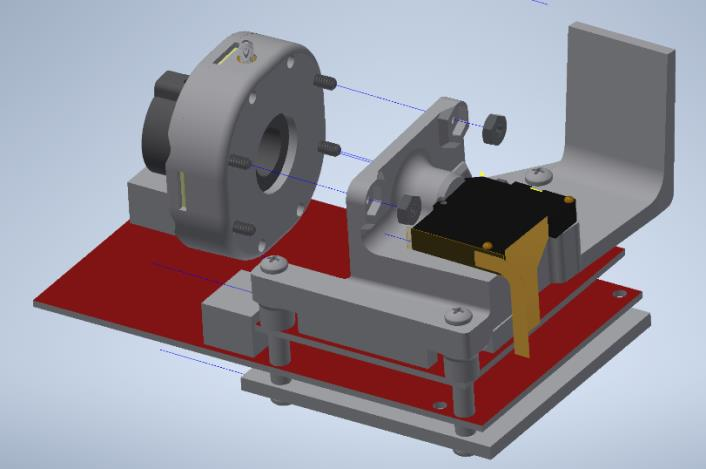
[picture p76: figure]
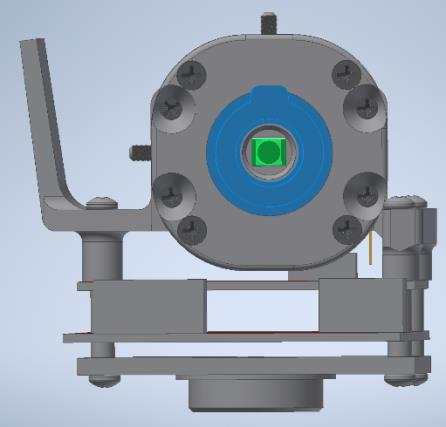
[picture p77: figure]

2. Sight down the barrel of the LLG adapter and adjust the ultra-fine set screws until it is aligned with the LED lens assembly in the optical engine.

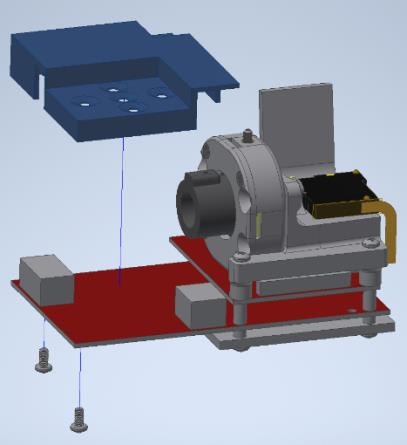
[picture p78: figure]

3. Place the PROJECTOR LIGHTBLOCK and secure with an M3 screw from disassembly step #6

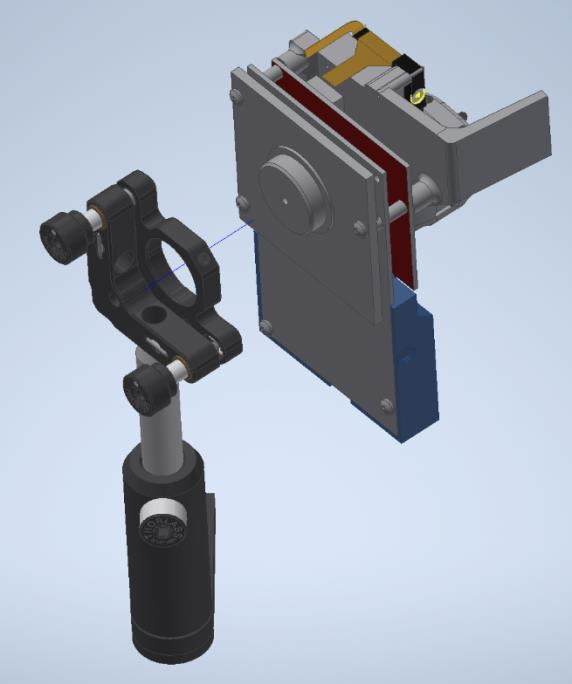
[picture p79: figure]

4. Attach projector assembly to the thorlab KM100 and post.
