haberkern-lab/ethoVR/assets/LLGA_step1.png

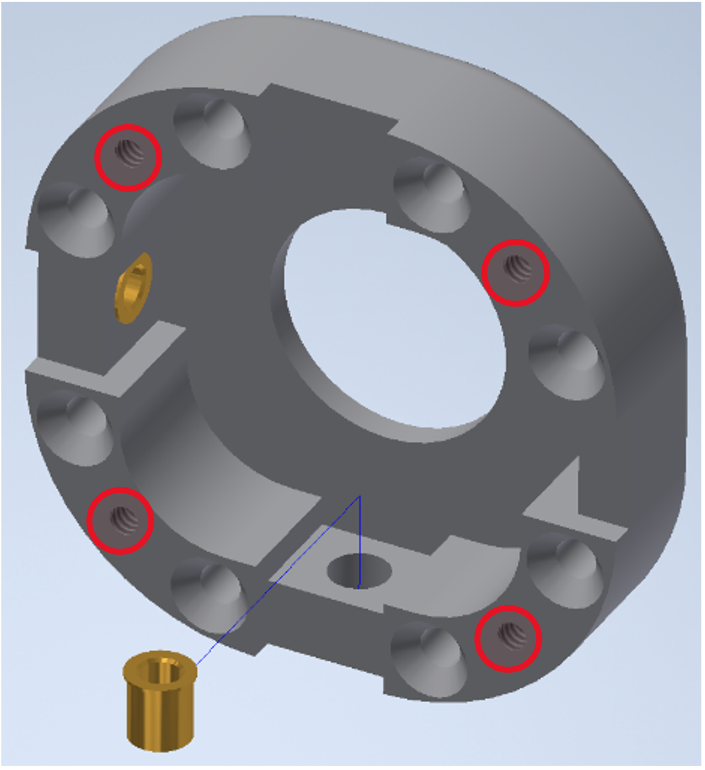
assets/LLGA_step1.png
