haberkern-lab/ethoVR/assets/LLGA_step3.png

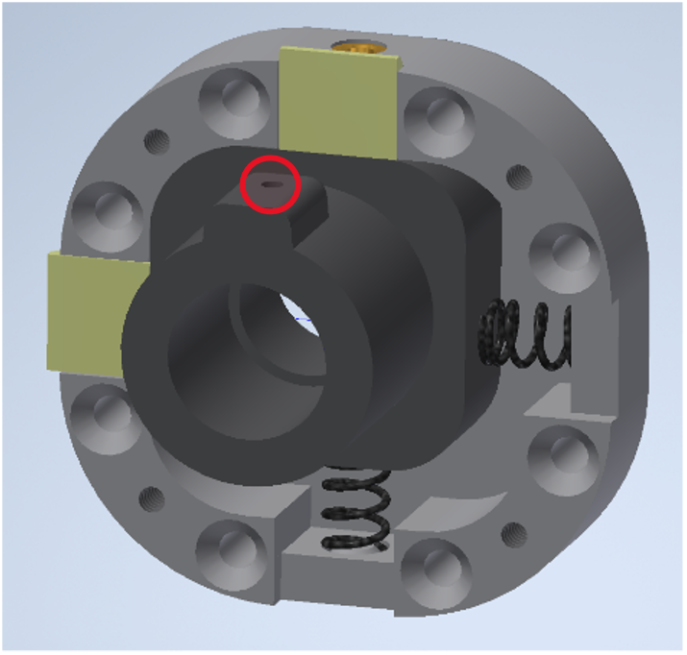
assets/LLGA_step3.png
