haberkern-lab/ethoVR/assets/LLGA_step7.png

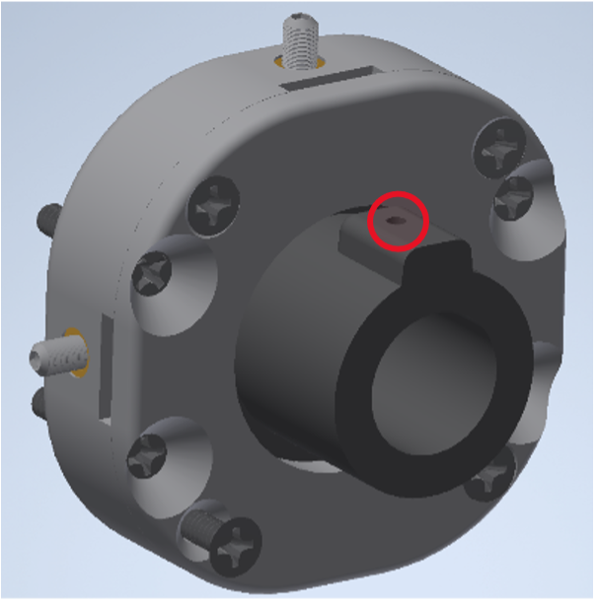
assets/LLGA_step7.png
