haberkern-lab/ethoVR/assets/LLGAProjector_step3.png

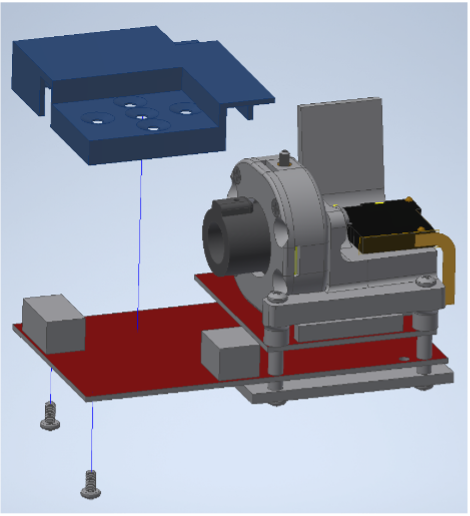
assets/LLGAProjector_step3.png
