haberkern-lab/ethoVR/assets/projectorModification/projectorReassembly_step4.png

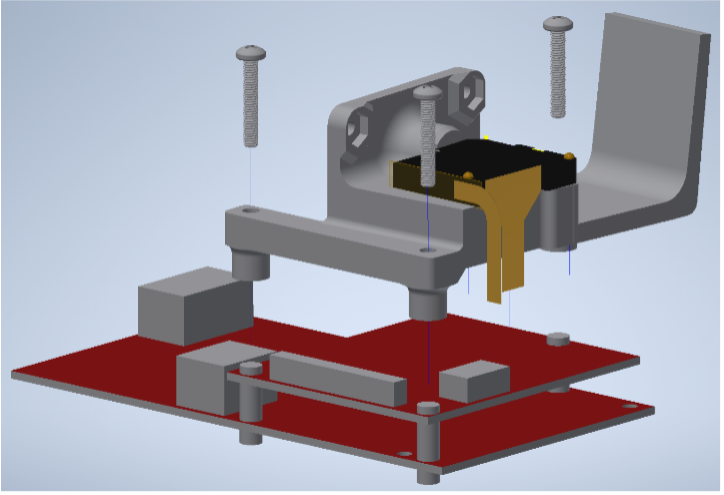
assets/projectorModification/projectorReassembly_step4.png
