haberkern-lab/ethoVR/assets/projectorModification/projectorReassembly_step5.jpg

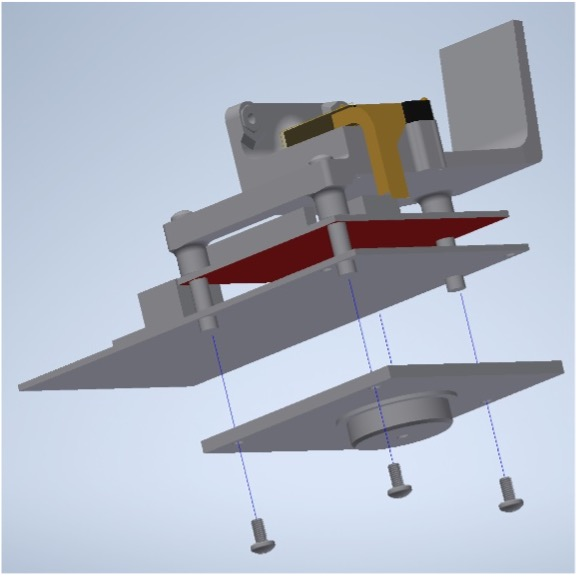
assets/projectorModification/projectorReassembly_step5.jpg
