haberkern-lab/ethoVR/assets/display/4projectorScreen/SCREEN FOLD PATTERN.pdf

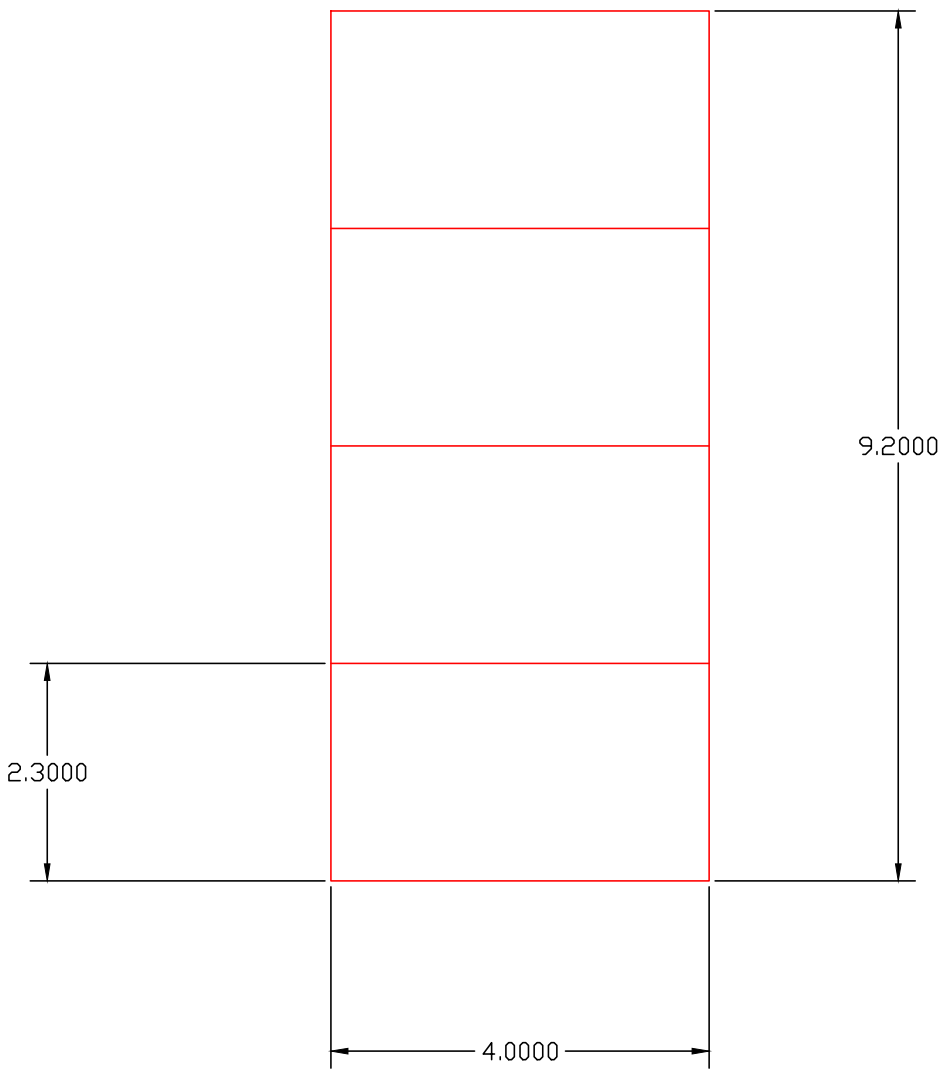
[picture p96: page 1]
