haberkern-lab/ethoVR/(commit log)

2022-06-07 screen assembly pictures
2022-06-07 create nested pages for display materials
2022-06-07 add schematic
2022-06-08 add color scheme switch
2022-06-08 update color scheme button
2022-11-30 added model files for the screen
    [3010 MOUNT PLATE RETAINER FIXED.stl, 3010 MOUNT PLATE.stl, BOTTOM SCREEN SUPPORT FRAME.stl, CENTERFINDING JIG.stl, LIGHT GUIDE ADAPTER.stl, PCB BRACE.stl, SCREEN ASSEMBLY GUIDE.stl, TOP SCREEN SUPPORT FRAME.stl]
2022-12-01 add info on ball materials
2022-12-06 added missing model files for projector modification
    [CORNER FLYVR PIVOT MOUNTPLATE v2.stl, FLYVR PIVOT MOUNTPLATE.stl, PROJECTOR LIGHTBLOCK 2.stl, PROJECTOR MOUNT FOR ADJ XY LLG V2.stl, XY LINEAR GUIDE BLOCKS.stl, XY SLIDE BOTTOM.stl, XY SLIDE PLATE.stl, XY SLIDE TOP.stl]
2022-12-21 add info on fly holder
    [FlyHolder_PyramidMount_V3_WIDEVIEW.ipt, FlyHolder_PyramidMount_V3_WIDEVIEW.stl, FlyHolder_PyramidMount_V3_WIDEVIEW.stp, METAL FLY PYRAMID CENTERED V2.ipt, METAL_FLY_PYRAMID_CENTERED_V2.dxf]
2022-12-21 add connector piece
2023-05-23 add info on fictrac configuration
    [grasshop_socket_config.txt]
2023-05-23 add comment on display cameras
2023-05-23 add model files for 3-projector screen
    [BOTTOM SCREEN SUPPORT 3P.ipt, CENTERING JIG 3P.ipt, SCREEN 3P.ipt, SCREEN ASSEMBLY GUIDE 3P.ipt, SCREEN ASSEMBLY GUIDE 3P_MIR.ipt, SCREEN HOLDER 3P.iam, TOP SCREEN SUPPORT 3P FRAME.ipt, WIDE SCREEN HOLDER 3P.ipt]
2024-01-26 tidy files for two projector display
    [3010 MOUNT PLATE RETAINER FIXED.stl, 3010 MOUNT PLATE.stl, ALIGNMENT JIG 2SCREEN.dxf, ALIGNMENT JIG 2SCREEN.ipt, BOTTOM SCREEN SUPPORT 2SCREEN.ipt, BOTTOM SCREEN SUPPORT 2SCREEN.stl, BOTTOM SCREEN SUPPORT 2SCREEN.stp, BOTTOM SCREEN SUPPORT FRAME.stl]
2024-01-26 file cleanup
    [BOTTOM SCREEN SUPPORT 3P.ipt, BOTTOM SCREEN SUPPORT 3P.stl, CENTERFINDING JIG.stl, CENTERING JIG 3P.ipt, CENTERING JIG 3P.stl, SCREEN 3P.ipt, SCREEN 3P.stl, SCREEN ASSEMBLY GUIDE 3P.ipt]
2024-01-26 moved projector assembly files
2024-01-26 add missing models for 4 projector screen
    [TOP SCREEN SUPPORT FRAME.stl, WIDE SCREEN HOLDER 2x.stl]
2024-01-26 rearrangement of folder for 2projector screen
    [BOTTOM SCREEN SUPPORT 2SCREEN.stl, BOTTOM SCREEN SUPPORT 2SCREEN.stp, SCREEN ASSEMBLY GUIDE.stl, TOP SCREEN SUPPORT 2SCREEN FRAME.stl, TOP SCREEN SUPPORT 2SCREEN FRAME.stp, WIDE SCREEN HOLDER 2SCREEN.stl, WIDE SCREEN HOLDER 2SCREEN.stp]
2024-01-26 fixed links, reorganized 3 projector files
    [SCREEN 3P.stl, _SCREEN ASSEMBLY GUIDE 3P_MIR.stl, _WIDE SCREEN HOLDER 3P_MIR.stl]
2024-01-26 files for projector 3010 mount
    [3010 MOUNT PLATE RETAINER.ipt, 3010 MOUNT PLATE RETAINER.stl, 3010 MOUNT PLATE RETAINER.stp, 3010 MOUNT PLATE.ipt, 3010 MOUNT PLATE.stl, 3010 MOUNT PLATE.stp, PCB BRACE.ipt, PCB BRACE.stl]
2024-01-26 files for projector light guide mod
    [LIGHT GUIDE ADAPTER.stl, PROJECTOR LIGHTBLOCK 2.stl, PROJECTOR MOUNT FOR ADJ XY LLG V2.stl]
2024-01-26 projector mount files
    [3010 MOUNT PLATE RETAINER.ipt, 3010 MOUNT PLATE RETAINER.stl, 3010 MOUNT PLATE RETAINER.stp, 3010 MOUNT PLATE.ipt, 3010 MOUNT PLATE.stl, 3010 MOUNT PLATE.stp, CORNER FLYVR PIVOT MOUNTPLATE v2.stl, FLYVR PIVOT MOUNTPLATE.stl]
2024-01-26 light guide mod files
    [XY SLIDE BOTTOM.stl, XY SLIDE PLATE.stl, XY SLIDE TOP.stl]
2024-01-26 add treadmill holder
    [TreadmillHolder_V2.stl]
2024-03-08 fixed references after move
    [LIGHT GUIDE ADAPTER.stl, PROJECTOR LIGHTBLOCK 2.stl, PROJECTOR MOUNT FOR ADJ XY LLG V2.stl]
2024-03-13 added assembly file, renaming
    [SCREEN ASSEMBLY GUIDE 3P_MIR.stl, WIDE SCREEN HOLDER 3P_MIR.stl]
2025-01-10 add tip for cutting the screen material
2026-02-27 moved mode files
    [3010 MOUNT PLATE RETAINER.stl, 3010 MOUNT PLATE.stl, CORNER FLYVR PIVOT MOUNTPLATE v2.stl, FLYVR PIVOT MOUNTPLATE.stl, PCB BRACE.stl]
2026-02-27 moved all model files to one directory
    [ALIGNMENT JIG 2SCREEN.dxf, BOTTOM SCREEN SUPPORT 2SCREEN.stl, BOTTOM SCREEN SUPPORT 2SCREEN.stp, BOTTOM SCREEN SUPPORT 3P.stl, CENTERING JIG 3P.stl, LIGHT GUIDE ADAPTER.stl, PROJECTOR LIGHTBLOCK 2.stl, PROJECTOR MOUNT FOR ADJ XY LLG V2.stl]
